kaibrooks/synthy/README.md

# synthy
PROJECT THEREMIZER

This file describes the THEREMIZER built by Bader Almatouq, Kai Brooks, Andrew Forsman, and Jeff Roman in Fall 
of 2019 for ECE 411 at Portland State University.
