kaibrooks/synthy/Homework/Functional Decomposition of Theremizer.pdf

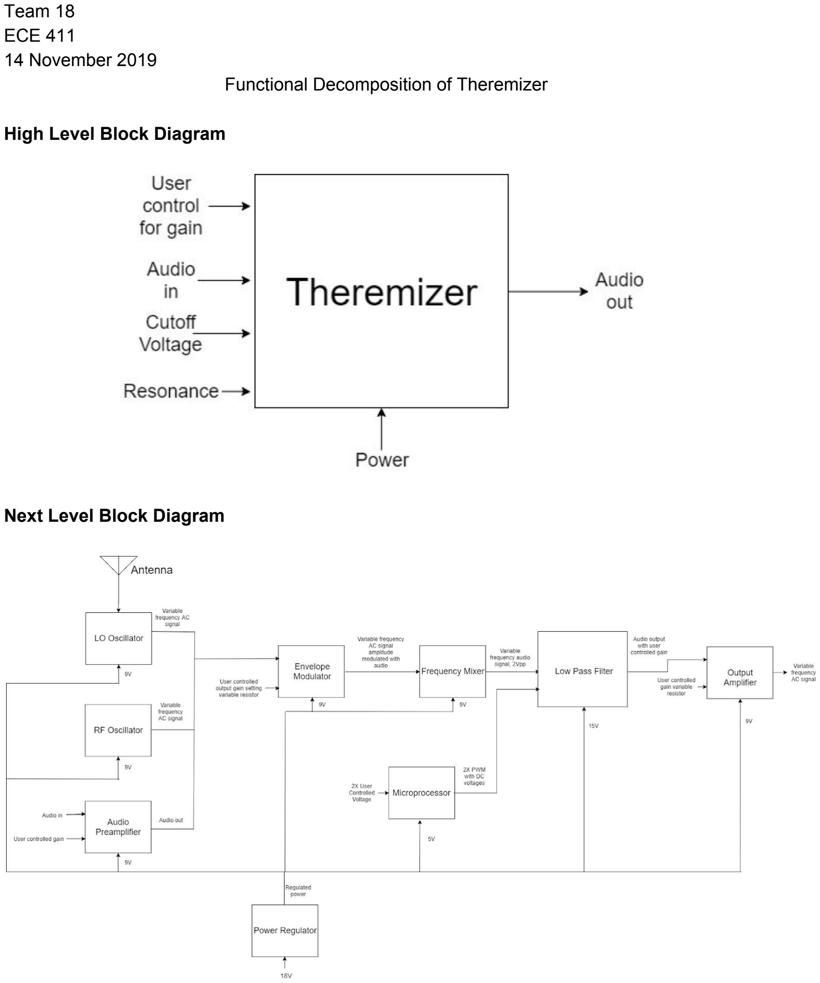
[picture p5: page 1]

Team 18
ECE 411
14 November 2019
Functional Decomposition of Theremizer

High Level Block Diagram

Next Level Block Diagram

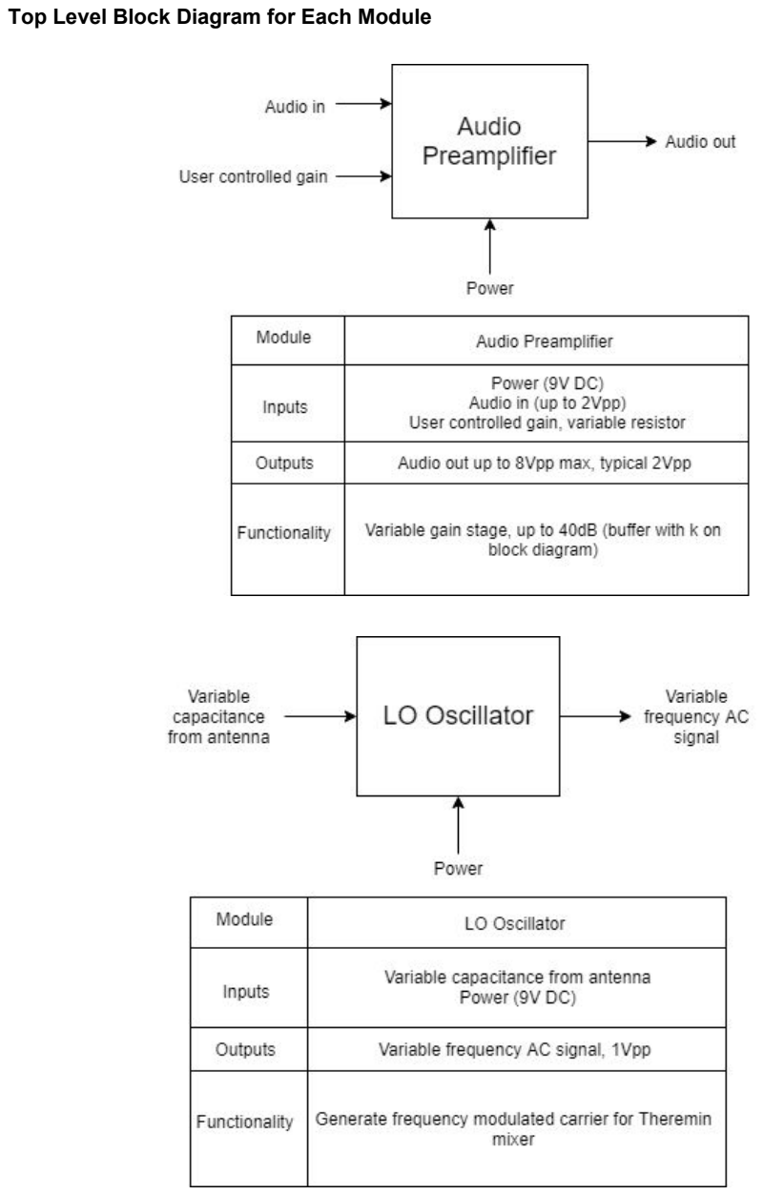
[picture p6: page 2]

Top Level Block Diagram for Each Module

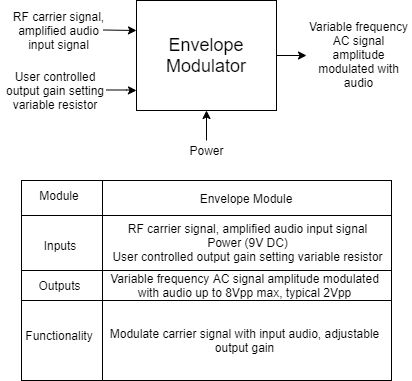
[picture p7: figure]
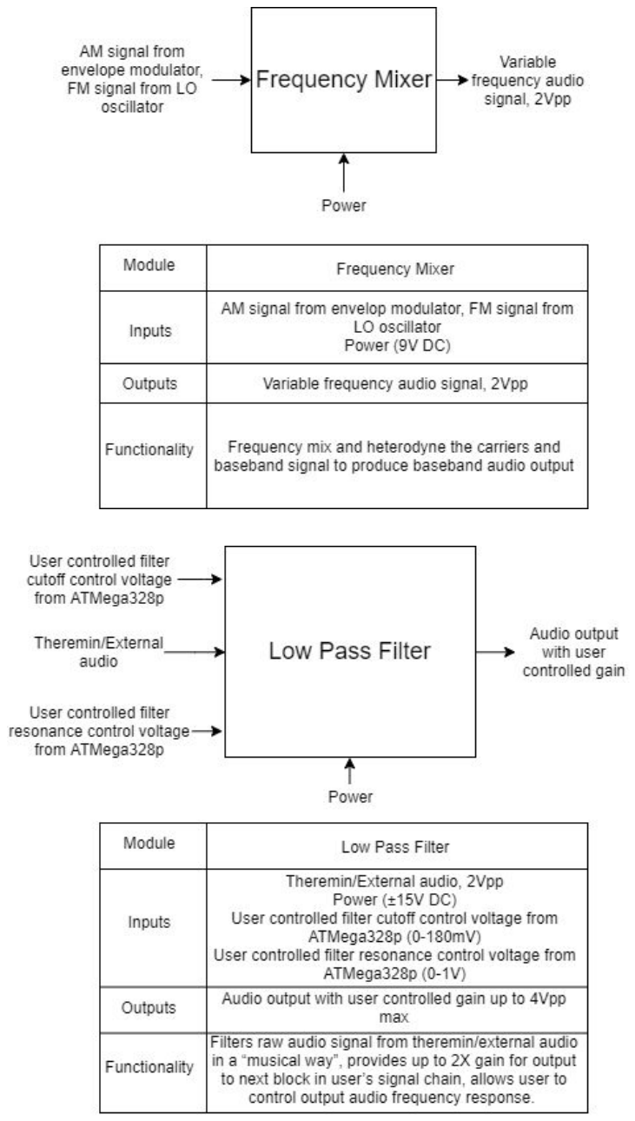
[picture p8: page 4]

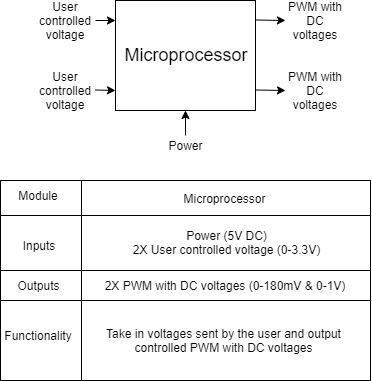
[picture p9: figure]
