kaibrooks/synthy/Breadboard Pics and Vids/Breadboard_Theremin_Powersupply_Filter.jpeg

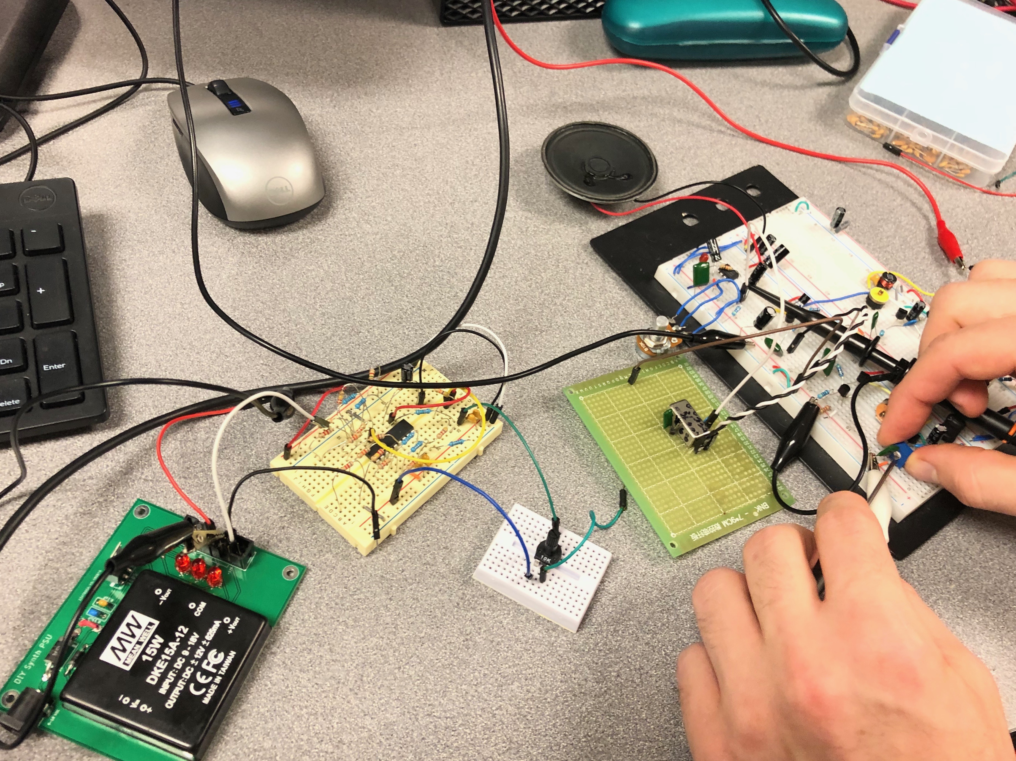
Breadboard Pics and Vids/Breadboard_Theremin_Powersupply_Filter.jpeg
