kaibrooks/synthy/Homework/Theremizer_Level_0_BD.png

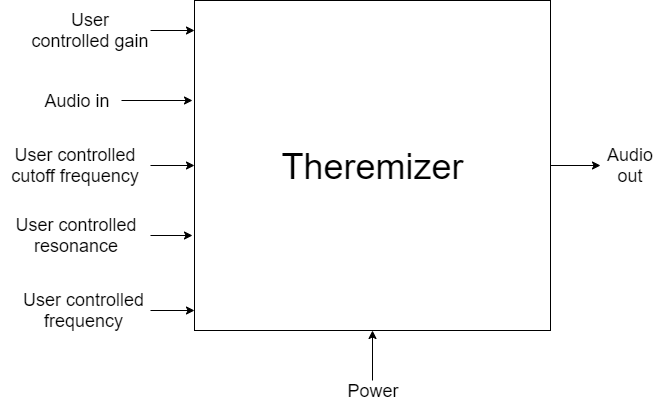
Homework/Theremizer_Level_0_BD.png
