kaibrooks/synthy/Homework/Theremizer_Level_1_BD.png

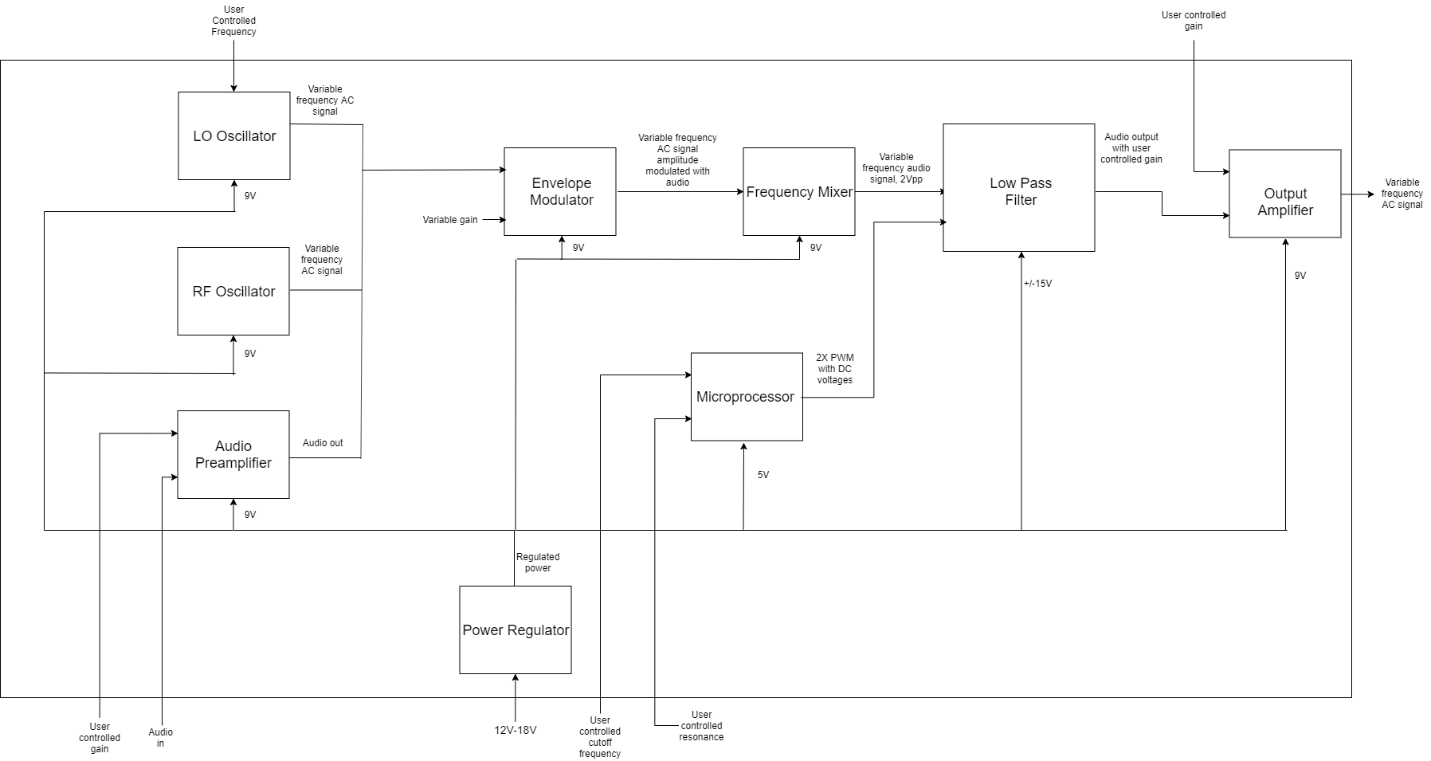
Homework/Theremizer_Level_1_BD.png
