kaibrooks/synthy/images/kitty.jpg

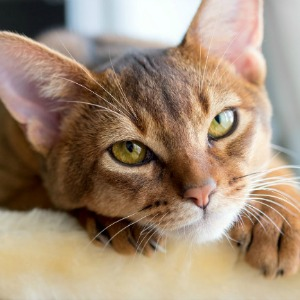
images/kitty.jpg
