kaibrooks/synthy/images/PCB layout.png

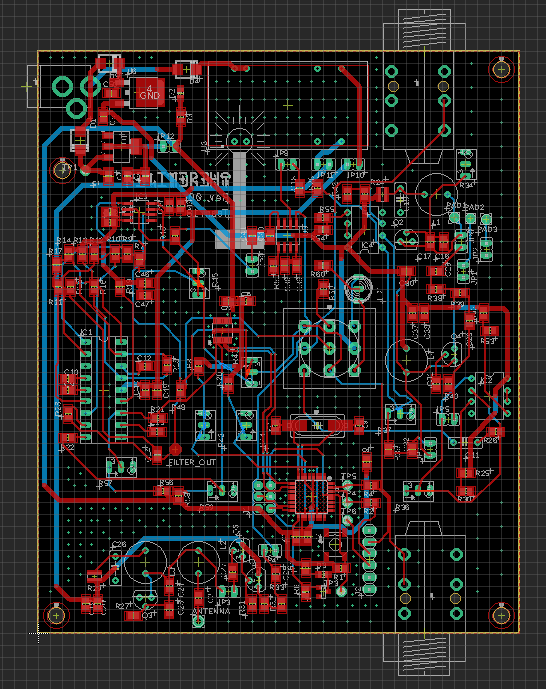
images/PCB layout.png
