kaibrooks/synthy/images/PWM_Code_Capture.PNG

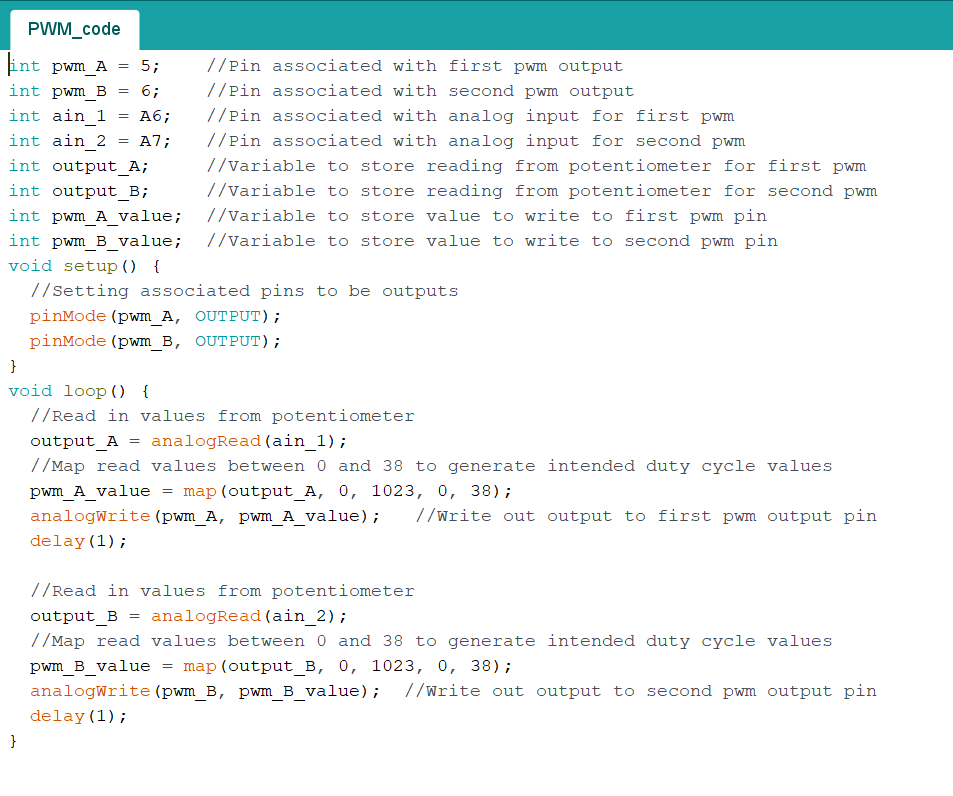
images/PWM_Code_Capture.PNG
