kaibrooks/synthy/EAGLE/Digikey Theremizer BOM.txt

Manufacturer Part Number	Manufacturer	Digi-Key Part Number	Customer Reference	Reference Designator	Packaging	Part Status	Quantity	Unit Price	Extended Price	Quantity Available	Mfg Std Lead Time	Description
PV36W104C01B00	Bourns Inc.	490-2876-ND			Tube	Active	8	1.5	$12.00 	10064	6 Weeks	TRIMMER 100K OHM 0.5W PC PIN TOP
RLB1314-103KL	Bourns Inc.	RLB1314-103KL-ND			Bag	Active	4	0.56	$2.24 	1099	14 Weeks	FIXED IND 10MH 100MA 12 OHM TH
RLB0608-102KL	Bourns Inc.	RLB0608-102KL-ND			Bag	Active	10	0.28	$2.80 	110816	14 Weeks	FIXED IND 1MH 100MA 11.5 OHM TH
RL622-101K-RC	Bourns Inc.	M9993-ND			Bulk	Active	4	0.95	$3.80 	10872	18 Weeks	FIXED IND 100UH 910MA 280 MOHM
PRG3216P-1000-D-T5	Susumu	408-1805-1-ND			Cut Tape (CT)	Active	10	0.491	$4.91 	1400	20 Weeks	RES SMD 100 OHM 1W 1206 WIDE
ERJ-PB6B4700V	Panasonic Electronic Components	P20556CT-ND			Cut Tape (CT)	Active	25	0.2228	$5.57 	9416	13 Weeks	RES SMD 470 OHM 0.1% 1/4W 0805
RK73H2ATTD47R0F	"KOA Speer Electronics, Inc."	2019-RK73H2ATTD47R0FCT-ND			Cut Tape (CT)	Active	10	0.035	$0.35 	21644	Not Available	RESISTOR
C0805C222KAGECAUTO	KEMET	399-17905-1-ND			Cut Tape (CT)	Active	20	0.196	$3.92 	4558	18 Weeks	CAP CER 0805 2.2NF 250V C0G
C0805C471F1GACTU	KEMET	399-8082-6-ND			Digi-Reel	Active	20	0.804	$16.08 	24430	46 Weeks	CAP CER 470PF 100V C0G/NP0 0805
C0805C104K3RACTU	KEMET	399-1168-1-ND			Cut Tape (CT)	Active	100	0.0646	$6.46 	899523	54 Weeks	CAP CER 0.1UF 25V X7R 0805
UKL2A100KPD	Nichicon	493-14498-ND			Bulk	Active	12	0.398	$4.77 	1209	19 Weeks	CAP ALUM 10UF 10% 100V RADIAL
STC02SYAN	Sullins Connector Solutions	S9000-ND			Bulk	Active	50	0.1	$5.00 	105643	5 Weeks	CONN JUMPER SHORTING TIN
ERJ-6GEY0R00V	Panasonic Electronic Components	P0.0ACT-ND			Cut Tape (CT)	Active	25	0.1	$2.50 	2004958	11 Weeks	RES SMD 0 OHM JUMPER 1/8W 0805
ERJ-6ENF1501V	Panasonic Electronic Components	P1.50KCCT-ND			Cut Tape (CT)	Active	10	0.1	$1.00 	201610	11 Weeks	RES SMD 1.5K OHM 1% 1/8W 0805
ERJ-6ENF1801V	Panasonic Electronic Components	P1.80KCCT-ND			Cut Tape (CT)	Active	10	0.11	$1.10 	71065	11 Weeks	RES SMD 1.8K OHM 1% 1/8W 0805
ERJ-6ENF1003V	Panasonic Electronic Components	P100KCCT-ND			Cut Tape (CT)	Active	100	0.1	$10.00 	1954422	11 Weeks	RES SMD 100K OHM 1% 1/8W 0805
PMV45EN2R	Nexperia USA Inc.	1727-2307-1-ND			Cut Tape (CT)	Active	5	0.43	$2.15 	93483	4 Weeks	MOSFET N-CH 30V SOT23
NCP1117ST50T3G	ON Semiconductor	NCP1117ST50T3GOSCT-ND			Cut Tape (CT)	Active	5	0.47	$2.35 	14163	4 Weeks	IC REG LINEAR 5V 1A SOT223
UA78M09CKVURG3	Texas Instruments	296-19533-1-ND			Cut Tape (CT)	Active	5	0.56	$2.80 	5206	6 Weeks	IC REG LINEAR 9V 500MA TO252-3
TL072CDT	STMicroelectronics	497-2200-1-ND			Cut Tape (CT)	Active	10	0.42	$4.20 	2188	10 Weeks	IC OPAMP JFET 2 CIRCUIT 8SO
ATMEGA328P-AU	Microchip Technology	ATMEGA328P-AU-ND			Tray	Active	4	2.01	$8.04 	5775	10 Weeks	IC MCU 8BIT 32KB FLASH 32TQFP
LTC2645CMS-L8#PBF	Linear Technology/Analog Devices	LTC2645CMS-L8#PBF-ND			Tube	Active	4	6.17	$24.68 	270	16 Weeks	IC DAC 8BIT V-OUT 16MSOP
MBRA130LT3G	ON Semiconductor	MBRA130LT3GOSCT-ND			Cut Tape (CT)	Active	20	0.37	$7.40 	44606	6 Weeks	DIODE SCHOTTKY 30V 1A SMA
LTST-C171GKT	Lite-On Inc.	160-1423-1-ND			Cut Tape (CT)	Active	10	0.28	$2.80 	284148	8 Weeks	LED GREEN CLEAR CHIP SMD
ECS-160-18-5PX-JES-TR	ECS Inc.	XC3075CT-ND			Cut Tape (CT)	Active	5	0.63	$3.15 	1972	9 Weeks	CRYSTAL 16.0000MHZ 18PF SMD
C0805C300K5GAC7800	KEMET	399-17443-1-ND			Cut Tape (CT)	Active	10	0.32	$3.20 	3822	47 Weeks	CAP CER 30PF 50V NP0 0805
C0805C221K5GACTU	KEMET	399-8038-1-ND			Cut Tape (CT)	Active	10	0.14	$1.40 	54135	46 Weeks	CAP CER 220PF 50V C0G/NP0 0805
CC0805KRX7R9BB301	Yageo	311-4329-1-ND			Cut Tape (CT)	Active	20	0.16	$3.20 	1232	17 Weeks	CAP CER 300PF 50V X7R 0805
C0805C102K5GACTU	KEMET	399-7988-1-ND			Cut Tape (CT)	Active	10	0.16	$1.60 	66815	52 Weeks	CAP CER 1000PF 50V C0G/NP0 0805
C0805C473K5RACTU	KEMET	399-1166-1-ND			Cut Tape (CT)	Active	5	0.18	$0.90 	1272598	29 Weeks	CAP CER 0.047UF 50V X7R 0805
C0805C334K5RACAUTO	KEMET	399-6959-1-ND			Cut Tape (CT)	Active	5	0.23	$1.15 	16103	27 Weeks	CAP CER 0.33UF 50V X7R 0805
C0805C105K5PAC7800	KEMET	399-15436-1-ND			Cut Tape (CT)	Active	5	0.33	$1.65 	11400	Not Available	CAP CER 1UF 50V X5R 0805
C0805C106K4PACTU	KEMET	399-8012-1-ND			Cut Tape (CT)	Active	100	0.19	$19.00 	84000	54 Weeks	CAP CER 10UF 16V X5R 0805
C0805C474J5RACTU	KEMET	399-11174-1-ND			Cut Tape (CT)	Active	5	0.98	$4.90 	9232	28 Weeks	CAP CER 0.47UF 50V X7R 0805
ERJ-6ENF9102V	Panasonic Electronic Components	P91.0KCCT-ND			Cut Tape (CT)	Active	20	0.1	$2.00 	50656	11 Weeks	RES SMD 91K OHM 1% 1/8W 0805
ERJ-6ENF2203V	Panasonic Electronic Components	P220KCCT-ND			Cut Tape (CT)	Active	20	0.1	$2.00 	312371	11 Weeks	RES SMD 220K OHM 1% 1/8W 0805
ERJ-6ENF2743V	Panasonic Electronic Components	P274KCCT-ND			Cut Tape (CT)	Active	10	0.11	$1.10 	73439	11 Weeks	RES SMD 274K OHM 1% 1/8W 0805
ERJ-6ENF1004V	Panasonic Electronic Components	P1.00MCCT-ND			Cut Tape (CT)	Active	5	0.1	$0.50 	280128	11 Weeks	RES SMD 1M OHM 1% 1/8W 0805
ERJ-6ENF4992V	Panasonic Electronic Components	P49.9KCCT-ND			Cut Tape (CT)	Active	20	0.1	$2.00 	346807	11 Weeks	RES SMD 49.9K OHM 1% 1/8W 0805
P160KNP-0EC15A100K	TT Electronics/BI	987-1717-ND			Tray	Active	8	0.79	$6.32 	1273	9 Weeks	POT 100K OHM 1/10W PLASTIC LOG
P160KNP-0QD20B10K	TT Electronics/BI	987-1662-ND			Tray	Active	8	0.79	$6.32 	1277	9 Weeks	POT 10K OHM 1/5W PLASTIC LINEAR
P160KNP-0EC15A25K	TT Electronics/BI	987-1721-ND			Tray	Active	4	0.79	$3.16 	425	9 Weeks	POT 25K OHM 1/10W PLASTIC LOG
ERJ-6ENF2201V	Panasonic Electronic Components	P2.20KCCT-ND			Cut Tape (CT)	Active	10	0.1	$1.00 	238068	11 Weeks	RES SMD 2.2K OHM 1% 1/8W 0805
ERJ-6ENF1001V	Panasonic Electronic Components	P1.00KCCT-ND			Cut Tape (CT)	Active	30	0.1	$3.00 	1311959	11 Weeks	RES SMD 1K OHM 1% 1/8W 0805
ERJ-6ENF1002V	Panasonic Electronic Components	P10.0KCCT-ND			Cut Tape (CT)	Active	25	0.1	$2.50 	2268302	11 Weeks	RES SMD 10K OHM 1% 1/8W 0805
ERJ-6ENF4703V	Panasonic Electronic Components	P470KCCT-ND			Cut Tape (CT)	Active	10	0.1	$1.00 	128684	11 Weeks	RES SMD 470K OHM 1% 1/8W 0805
P160KNP-0EC15A500K	TT Electronics/BI	987-1722-ND			Tray	Active	4	0.79	$3.16 	1139	9 Weeks	POT 500K OHM 1/10W PLASTIC LOG
3002	Adafruit Industries LLC	1528-2039-ND			Bulk	Active	4	0.63	$2.52 	394	12 Weeks	SHORT FEATHER MALE HEADERS - 12-
ERJ-6ENF1502V	Panasonic Electronic Components	P15.0KCCT-ND			Cut Tape (CT)	Active	10	0.1	$1.00 	293541	11 Weeks	RES SMD 15K OHM 1% 1/8W 0805
DCWN03A-15	MEAN WELL USA Inc.	1866-1277-ND			Tube	Active	4	8.83	$35.32 	55	14 Weeks	DC DC CONVERTER +/-15V 3W
PJ-202A	CUI Devices	CP-202A-ND			Bag	Active	4	0.6	$2.40 	13054	11 Weeks	CONN PWR JACK 2X5.5MM KINKED PIN
RS-187R05A2-DS MT RT	C&K	CKN10361CT-ND			Cut Tape (CT)	Active	4	0.53	$2.12 	6547	7 Weeks	SWITCH TACTILE SPST-NO 0.05A 12V
1003P1T1B1M2QEH	E-Switch	EG2425-ND			Bulk	Active	4	5.72	$22.88 	121	10 Weeks	SWITCH TOGGLE 3PDT 5A 120V
DILB8P-223TLF	Amphenol ICC (FCI)	609-4717-ND			Tube	Active	8	0.16	$1.28 	127	11 Weeks	CONN IC DIP SOCKET 8POS TIN
DILB16P-223TLF	Amphenol ICC (FCI)	609-4713-ND			Tube	Active	4	0.3	$1.20 	2718	11 Weeks	CONN IC DIP SOCKET 16POS TIN
