kaibrooks/synthy/Final_bom.xlsx

SOURCE | Item #, Name, or Link |  | Item | Cost | Quantity Priced | Used per Build | Quantity to Order | Already Ordered? | Package Details
Amazon | https://www.amazon.com/TOTOT-5-5mm-Female-Socket-Electrical/dp/B077YB75N3 |  | DC Barrel Jacks | 5.99 | 10 | 1 | 1 | Yes
 | https://www.amazon.com/gp/product/B077X95CWF/ref=ox_sc_act_title_5?smid=A3S1JN3RP90N86&psc=1 |  | Red/Blue LEDs | 6.79 | 100 | 1 | 1 | Yes
 | https://www.amazon.com/ZXHAO-6-35mm-Socket-Electric-Guitar/dp/B07FB944VD |  | Mono Instrument Jacks | 7.19 | 20 | 2 | 1 | Yes
 | https://www.amazon.com/gp/product/B07233GJ6M/ref=ox_sc_act_title_2?smid=A1TBO7AH1TIA3O&psc=1 |  | PG7 Cable Glands for Antenna Mount | 5.99 | 6 | 1 | 1 | Yes
 | https://www.amazon.com/dp/B071483R3F |  | M2.5 Nylon Standoffs | 12.99 | 270 | 2 | 1 | Yes
 | https://www.amazon.com/gp/product/B00K85965W/ref=ox_sc_act_title_1?smid=ATVPDKIKX0DER&psc=1 |  | LED Mounts | 4.92 | 50 | 1 | 1 | Yes
 | https://www.amazon.com/gp/product/B07M81Y8CS/ref=ox_sc_act_title_3?smid=A26VZBPE6PT1GF&psc=1 |  | Potentiometer Knobs | 12.99 | 20 | 2 | 1 | Yes
 | https://www.amazon.com/gp/product/B07W1JLTGC/ref=ppx_yo_dt_b_asin_title_o00_s00?ie=UTF8&psc=1 |  | 7-section Telescoping Antennas | 7.99 | 2 | 1 | 1 | Yes
 | https://www.amazon.com/gp/product/B07V5GGJXC/ref=ppx_yo_dt_b_asin_title_o03_s00?ie=UTF8&psc=1 |  | J310 FETs | 5.99 | 10 | 3 | 2 | Yes | TO-92
 | https://www.amazon.com/gp/product/B00B88F94A/ref=ppx_yo_dt_b_asin_title_o07_s01?ie=UTF8&psc=1 |  | NE5532 Op-Amps | 7.38 | 10 | 1 | 1 | Yes | DIP-8
 | https://www.amazon.com/Ximimark-MTS-302-Toggle-Switch-Latching/dp/B07GWGN6D4 |  | 3PDT Toggle Switches | 6.59 | 4 | 1 | 1 | Yes
 |  |  | Header Pins, a whole lot of them. | 6.99 | 1 | 1 | 1 | Yes
 |  |  | TL072 Op-Amps | 4.99 |  |  |  |  | DIP-8
EBAY | 223p Trimmer Capacitors, Dual 1-60/1-140 |  | Duplex 60/140pF Trimmer Capacitors | 5.7 | 5 | 1 | 1 | Yes
 |  |  | NE602 Mixers | 8.95 | 10 | 1 | 1 | Yes | SO-8
 |  |  | 2N5088 BJTs | 4.99 | 100 | 2 | 1 | Yes | TO-92
Digi-Key
Description | Manufacturer Part Number | Manufacturer | Digi-Key Part Number | Part Status | Quantity | Unit Price | Extended Price
TRIMMER 100K OHM 0.5W PC PIN TOP | PV36W104C01B00 | Bourns Inc. | 490-2876-ND | Active | 8 | 1.5 | $12.00
FIXED IND 10MH 100MA 12 OHM TH | RLB1314-103KL | Bourns Inc. | RLB1314-103KL-ND | Active | 4 | 0.56 | $2.24
FIXED IND 1MH 100MA 11.5 OHM TH | RLB0608-102KL | Bourns Inc. | RLB0608-102KL-ND | Active | 10 | 0.28 | $2.80
FIXED IND 100UH 910MA 280 MOHM | RL622-101K-RC | Bourns Inc. | M9993-ND | Active | 4 | 0.95 | $3.80
RES SMD 100 OHM 1W 1206 WIDE | PRG3216P-1000-D-T5 | Susumu | 408-1805-1-ND | Active | 10 | 0.491 | $4.91
RES SMD 470 OHM 0.1% 1/4W 0805 | ERJ-PB6B4700V | Panasonic Electronic Components | P20556CT-ND | Active | 25 | 0.2228 | $5.57
RESISTOR | RK73H2ATTD47R0F | KOA Speer Electronics, Inc. | 2019-RK73H2ATTD47R0FCT-ND | Active | 10 | 0.033 | $0.33
CAP CER 0805 2.2NF 250V C0G | C0805C222KAGECAUTO | KEMET | 399-17905-1-ND | Active | 20 | 0.196 | $3.92
CAP CER 470PF 100V C0G/NP0 0805 | C0805C471F1GACTU | KEMET | 399-8082-6-ND | Active | 20 | 0.804 | $16.08
CAP CER 0.1UF 25V X7R 0805 | C0805C104K3RACTU | KEMET | 399-1168-1-ND | Active | 100 | 0.0646 | $6.46
CAP ALUM 10UF 10% 100V RADIAL | UKL2A100KPD | Nichicon | 493-14498-ND | Active | 12 | 0.398 | $4.77
CONN JUMPER SHORTING TIN | STC02SYAN | Sullins Connector Solutions | S9000-ND | Active | 50 | 0.0378 | $1.89
RES SMD 0 OHM JUMPER 1/8W 0805 | ERJ-6GEY0R00V | Panasonic Electronic Components | P0.0ACT-ND | Active | 25 | 0.0432 | $1.08
RES SMD 1.5K OHM 1% 1/8W 0805 | ERJ-6ENF1501V | Panasonic Electronic Components | P1.50KCCT-ND | Active | 10 | 0.075 | $0.75
RES SMD 1.8K OHM 1% 1/8W 0805 | ERJ-6ENF1801V | Panasonic Electronic Components | P1.80KCCT-ND | Active | 10 | 0.089 | $0.89
RES SMD 100K OHM 1% 1/8W 0805 | ERJ-6ENF1003V | Panasonic Electronic Components | P100KCCT-ND | Active | 100 | 0.0275 | $2.75
MOSFET N-CH 30V SOT23 | PMV45EN2R | Nexperia USA Inc. | 1727-2307-1-ND | Active | 5 | 0.43 | $2.15
IC REG LINEAR 5V 1A SOT223 | NCP1117ST50T3G | ON Semiconductor | NCP1117ST50T3GOSCT-ND | Active | 5 | 0.47 | $2.35
IC REG LINEAR 9V 500MA TO252-3 | UA78M09CKVURG3 | Texas Instruments | 296-19533-1-ND | Active | 5 | 0.56 | $2.80
IC OPAMP JFET 2 CIRCUIT 8SO | TL072CDT | STMicroelectronics | 497-2200-1-ND | Active | 10 | 0.363 | $3.63
IC MCU 8BIT 32KB FLASH 32TQFP | ATMEGA328P-AU | Microchip Technology | ATMEGA328P-AU-ND | Active | 4 | 2.01 | $8.04
IC DAC 8BIT V-OUT 16MSOP | LTC2645CMS-L8#PBF | Linear Technology/Analog Devices | LTC2645CMS-L8#PBF-ND | Active | 4 | 6.17 | $24.68
DIODE SCHOTTKY 30V 1A SMA | MBRA130LT3G | ON Semiconductor | MBRA130LT3GOSCT-ND | Active | 20 | 0.28 | $5.60
LED GREEN CLEAR CHIP SMD | LTST-C171GKT | Lite-On Inc. | 160-1423-1-ND | Active | 10 | 0.201 | $2.01
CRYSTAL 16.0000MHZ 18PF SMD | ECS-160-18-5PX-JES-TR | ECS Inc. | XC3075CT-ND | Active | 5 | 0.63 | $3.15
CAP CER 30PF 50V NP0 0805 | C0805C300K5GAC7800 | KEMET | 399-17443-1-ND | Active | 10 | 0.216 | $2.16
CAP CER 220PF 50V C0G/NP0 0805 | C0805C221K5GACTU | KEMET | 399-8038-1-ND | Active | 10 | 0.101 | $1.01
CAP CER 300PF 50V X7R 0805 | CC0805KRX7R9BB301 | Yageo | 311-4329-1-ND | Active | 20 | 0.111 | $2.22
CAP CER 1000PF 50V C0G/NP0 0805 | C0805C102K5GACTU | KEMET | 399-7988-1-ND | Active | 10 | 0.112 | $1.12
CAP CER 0.047UF 50V X7R 0805 | C0805C473K5RACTU | KEMET | 399-1166-1-ND | Active | 5 | 0.18 | $0.90
CAP CER 0.33UF 50V X7R 0805 | C0805C334K5RACAUTO | KEMET | 399-6959-1-ND | Active | 5 | 0.23 | $1.15
CAP CER 1UF 50V X5R 0805 | C0805C105K5PAC7800 | KEMET | 399-15436-1-ND | Active | 5 | 0.33 | $1.65
CAP CER 10UF 16V X5R 0805 | C0805C106K4PACTU | KEMET | 399-8012-1-ND | Active | 100 | 0.0663 | $6.63
CAP CER 0.47UF 50V X7R 0805 | C0805C474J5RACTU | KEMET | 399-11174-1-ND | Active | 5 | 0.98 | $4.90
RES SMD 91K OHM 1% 1/8W 0805 | ERJ-6ENF9102V | Panasonic Electronic Components | P91.0KCCT-ND | Active | 20 | 0.072 | $1.44
RES SMD 220K OHM 1% 1/8W 0805 | ERJ-6ENF2203V | Panasonic Electronic Components | P220KCCT-ND | Active | 20 | 0.072 | $1.44
RES SMD 274K OHM 1% 1/8W 0805 | ERJ-6ENF2743V | Panasonic Electronic Components | P274KCCT-ND | Active | 10 | 0.087 | $0.87
RES SMD 1M OHM 1% 1/8W 0805 | ERJ-6ENF1004V | Panasonic Electronic Components | P1.00MCCT-ND | Active | 5 | 0.1 | $0.50
RES SMD 49.9K OHM 1% 1/8W 0805 | ERJ-6ENF4992V | Panasonic Electronic Components | P49.9KCCT-ND | Active | 20 | 0.072 | $1.44
POT 100K OHM 1/10W PLASTIC LOG | P160KNP-0EC15A100K | TT Electronics/BI | 987-1717-ND | Active | 8 | 0.79 | $6.32
POT 10K OHM 1/5W PLASTIC LINEAR | P160KNP-0QD20B10K | TT Electronics/BI | 987-1662-ND | Active | 8 | 0.79 | $6.32
POT 25K OHM 1/10W PLASTIC LOG | P160KNP-0EC15A25K | TT Electronics/BI | 987-1721-ND | Active | 4 | 0.79 | $3.16
RES SMD 2.2K OHM 1% 1/8W 0805 | ERJ-6ENF2201V | Panasonic Electronic Components | P2.20KCCT-ND | Active | 10 | 0.074 | $0.74
RES SMD 1K OHM 1% 1/8W 0805 | ERJ-6ENF1001V | Panasonic Electronic Components | P1.00KCCT-ND | Active | 30 | 0.072 | $2.16
RES SMD 10K OHM 1% 1/8W 0805 | ERJ-6ENF1002V | Panasonic Electronic Components | P10.0KCCT-ND | Active | 25 | 0.072 | $1.80
RES SMD 470K OHM 1% 1/8W 0805 | ERJ-6ENF4703V | Panasonic Electronic Components | P470KCCT-ND | Active | 10 | 0.072 | $0.72
POT 500K OHM 1/10W PLASTIC LOG | P160KNP-0EC15A500K | TT Electronics/BI | 987-1722-ND | Active | 4 | 0.79 | $3.16
SHORT FEATHER MALE HEADERS - 12- | 3002 | Adafruit Industries LLC | 1528-2039-ND | Active | 4 | 0.63 | $2.52
RES SMD 15K OHM 1% 1/8W 0805 | ERJ-6ENF1502V | Panasonic Electronic Components | P15.0KCCT-ND | Active | 10 | 0.072 | $0.72
DC DC CONVERTER +/-15V 3W | DCWN03A-15 | MEAN WELL USA Inc. | 1866-1277-ND | Active | 4 | 9.08 | $36.32
CONN PWR JACK 2X5.5MM KINKED PIN | PJ-202A | CUI Devices | CP-202A-ND | Active | 4 | 0.6 | $2.40
SWITCH TACTILE SPST-NO 0.05A 12V | RS-187R05A2-DS MT RT | C&K | CKN10361CT-ND | Active | 4 | 0.53 | $2.12
SWITCH TOGGLE 3PDT 5A 120V | 1003P1T1B1M2QEH | E-Switch | EG2425-ND | Active | 4 | 5.72 | $22.88
CONN IC DIP SOCKET 8POS TIN | DILB8P-223TLF | Amphenol ICC (FCI) | 609-4717-ND | Active | 8 | 0.16 | $1.28
CONN IC DIP SOCKET 16POS TIN | DILB16P-223TLF | Amphenol ICC (FCI) | 609-4713-ND | Active | 4 | 0.3 | $1.20
CONN HEADER VERT 2POS 2.54MM | M20-9990246 | Harwin Inc. | 952-2262-ND | Active | 50 | 0.099 | $4.95
Total Cost | $367.28
Per Unit | $91.82
