kaibrooks/synthy/Homework/Theremizer_gantt.pdf

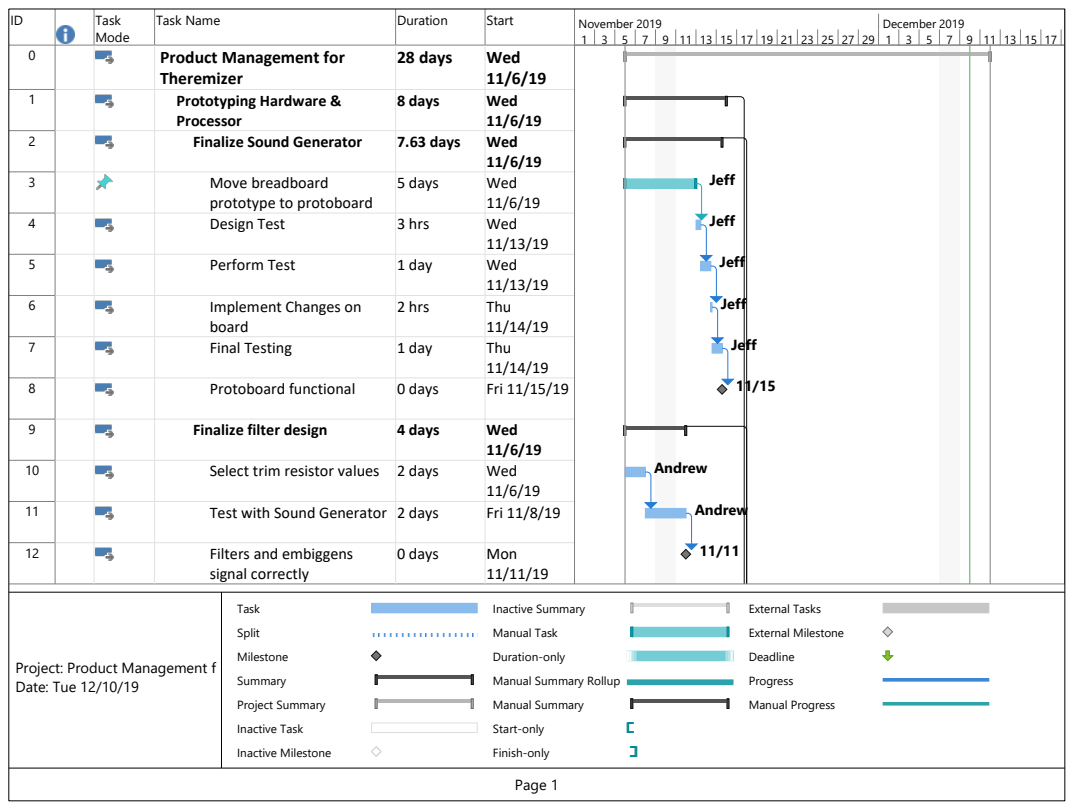
[picture p16: page 1]
Task; Mode; Task Name; Duration; Start; Product Management for; Theremizer; 28 days; Wed; Prototyping Hardware &; Processor; 8 days; Finalize Sound Generator; 7.63 days; Move breadboard; 5 days; Design Test; 3 hrs; Perform Test; 1 day; Implement Changes on; board; 2 hrs; Thu; Final Testing; Protoboard functional; 0 days; Fri 11/15/19; Finalize filter design; 4 days; Select trim resistor values; 2 days; Test with Sound Generator; Fri 11/8/19; Filters and embiggens; signal correctly; Mon; Jeff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

prototype to protoboard

Project: Product Management f
Date: Tue 12/10/19

Manual Summary Rollup

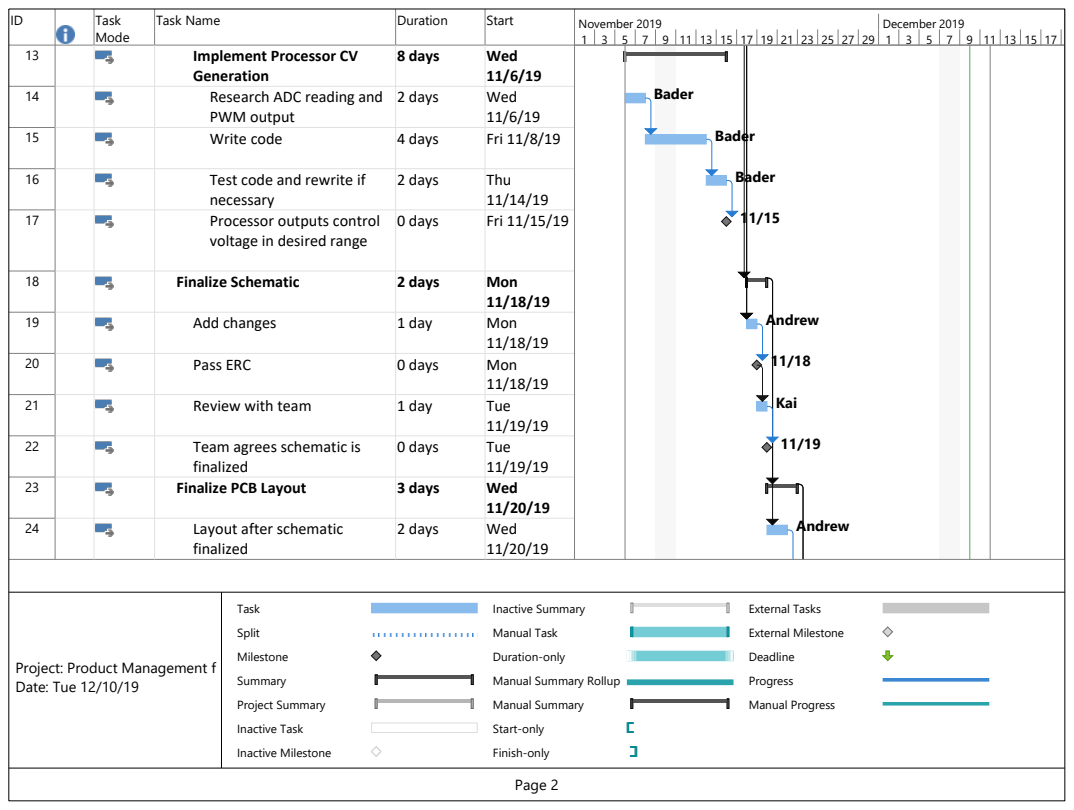
[picture p17: page 2]
Mode; Implement Processor CV; Generation; 8 days; Wed; Research ADC reading and; PWM output; 2 days; Write code; 4 days; Fri 11/8/19; Test code and rewrite if; necessary; Thu; Processor outputs control; 0 days; Fri 11/15/19; Finalize Schematic; Mon; Add changes; 1 day; Pass ERC; Review with team; Tue; Team agrees schematic is; finalized; Finalize PCB Layout; 3 days; Layout after schematic; Bader; Andrew; Kai; Task; Split; Milestone; Summary; Project Summary; Inactive Task; Inactive Milestone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

voltage in desired range

Project: Product Management f
Date: Tue 12/10/19

Manual Summary Rollup

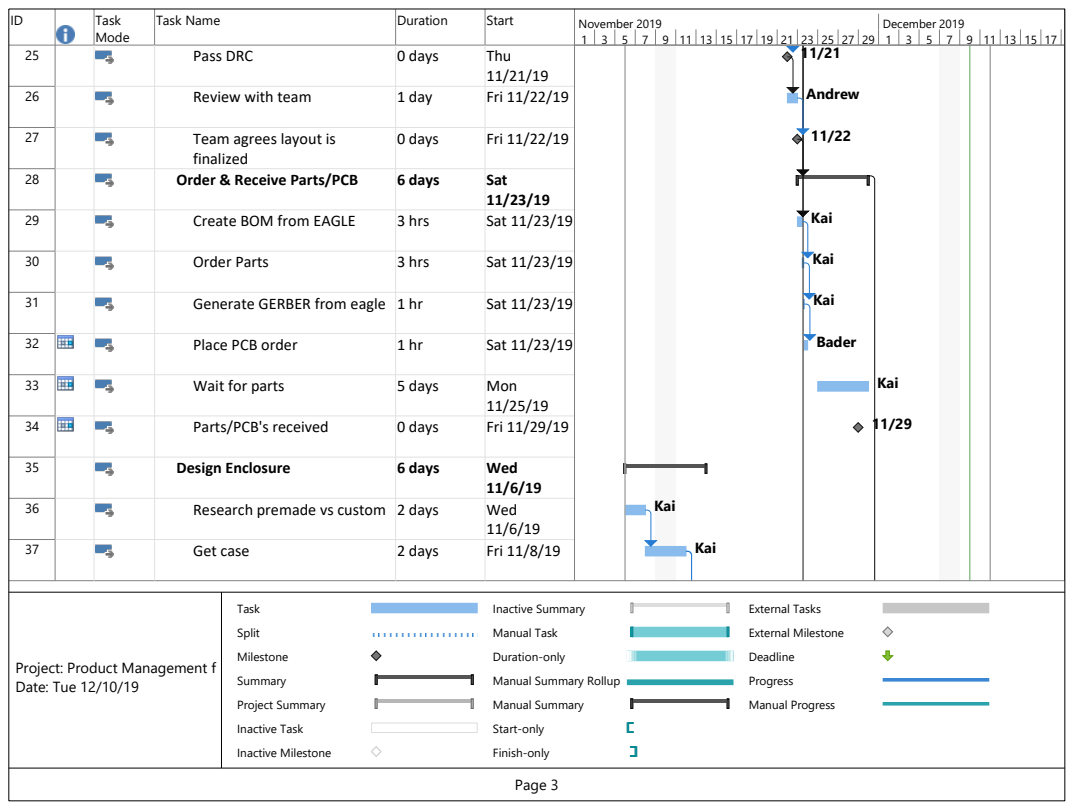
[picture p18: page 3]
Mode; Pass DRC; 0 days; Thu; Review with team; 1 day; Fri 11/22/19; Team agrees layout is; finalized; Order & Receive Parts/PCB; 6 days; Sat; Create BOM from EAGLE; 3 hrs; Sat 11/23/19; Order Parts; Generate GERBER from eagle; Place PCB order; Wait for parts; 5 days; Mon; Parts/PCB's received; Fri 11/29/19; Design Enclosure; Wed; Research premade vs custom; 2 days; Get case; Fri 11/8/19; Andrew; Kai; Bader; Task; Split; Milestone; Summary; Project Summary; Inactive Task; Inactive Milestone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

Project: Product Management f
Date: Tue 12/10/19

Manual Summary Rollup

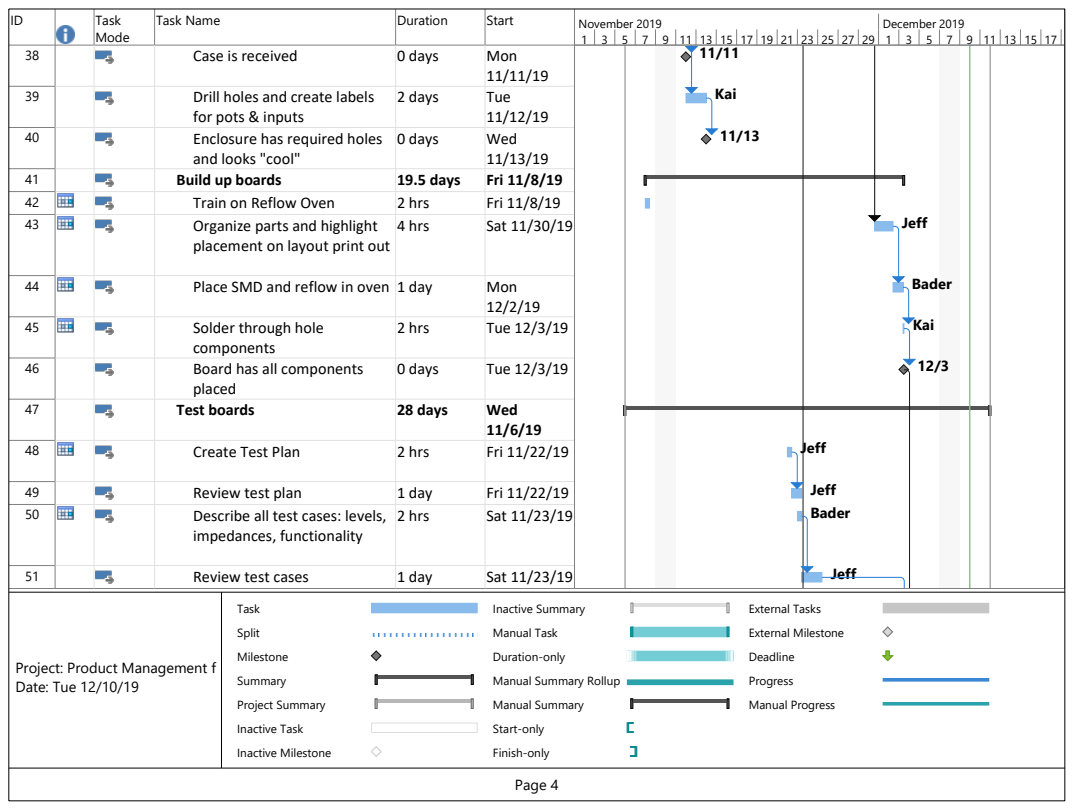
[picture p19: page 4]
Mode; Case is received; 0 days; Mon; Drill holes and create labels; 2 days; Tue; Enclosure has required holes; Wed; Build up boards; 19.5 days; Fri 11/8/19; Train on Reflow Oven; 2 hrs; Organize parts and highlight; 4 hrs; Sat 11/30/19; Place SMD and reflow in oven; 1 day; Solder through hole; components; Tue 12/3/19; Board has all components; placed; Test boards; 28 days; Create Test Plan; Fri 11/22/19; Review test plan; Describe all test cases: levels,; impedances, functionality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

for pots & inputs

and looks "cool"

placement on layout print out

Project: Product Management f
Date: Tue 12/10/19

Manual Summary Rollup

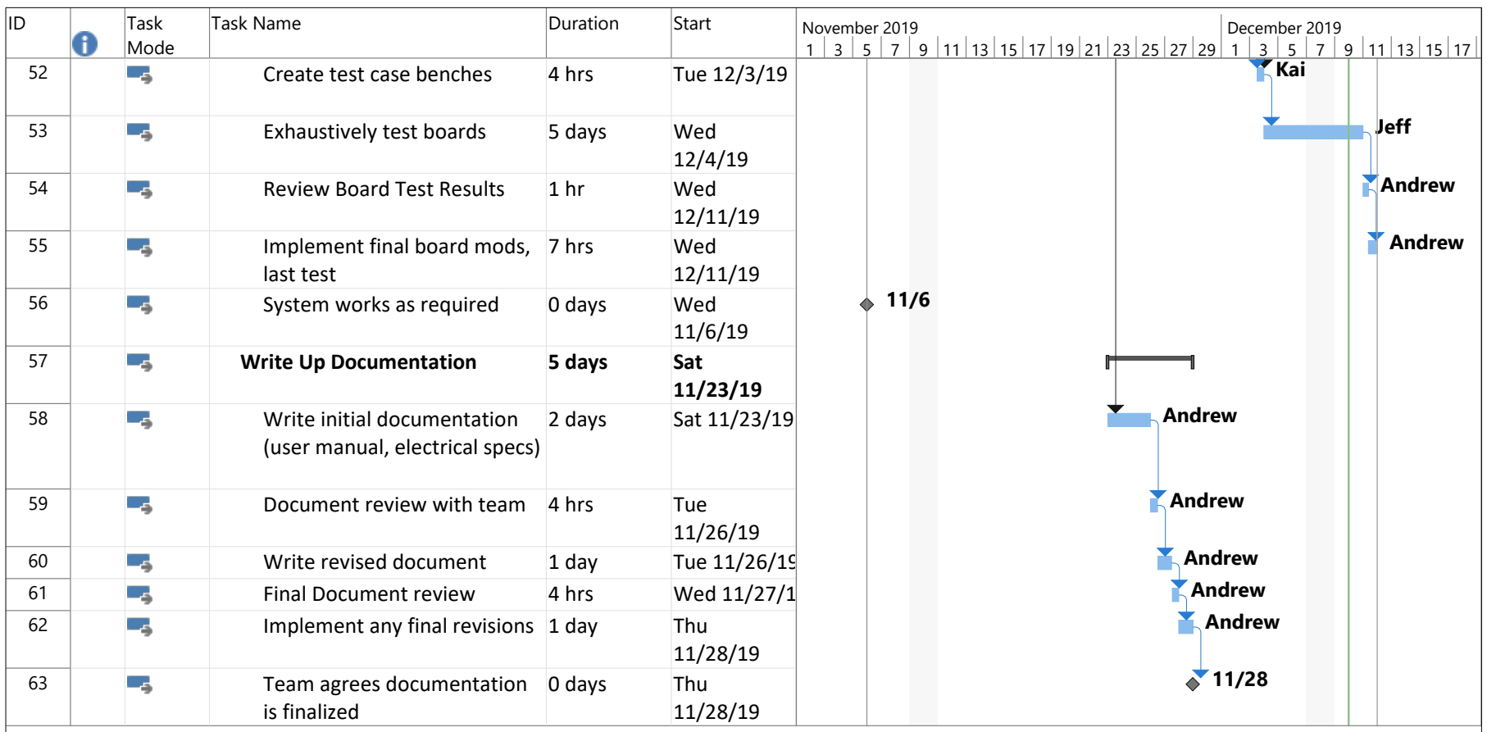
[picture p20: figure]
Mode; Create test case benches; 4 hrs; Tue 12/3/19; Exhaustively test boards; 5 days; Wed; Review Board Test Results; Implement final board mods,; last test; 7 hrs; System works as required; 0 days; Write Up Documentation; Sat; Write initial documentation; (user manual, electrical specs); 2 days; Sat 11/23/19; Document review with team; Tue; Write revised document; 1 day; Tue 11/26/19; Final Document review; Wed 11/27/19; Implement any final revisions; Thu; Team agrees documentation; is finalized; Kai; Jeff; Andrew
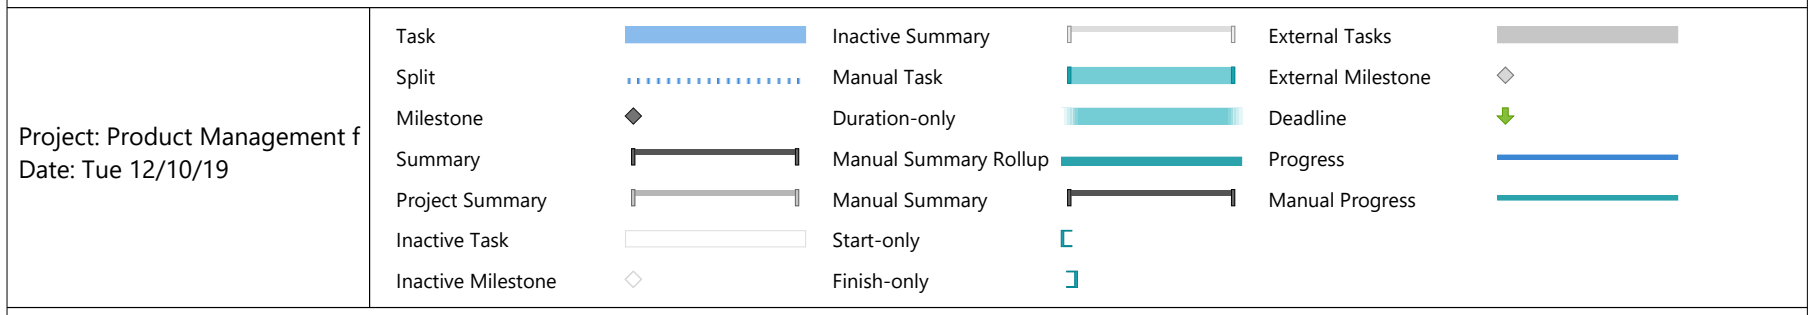
[picture p21: figure]
Task; Split; Milestone; Summary; Project Summary; Inactive Task; Inactive Milestone; Inactive Summary; Manual Task; Duration-only; Manual Summary Rollup; Manual Summary; Start-only; Finish-only; External Tasks; External Milestone; Deadline; Progress; Manual Progress; Project: Product Management f Date: Tue 12/10/19
