kaibrooks/synthy/EAGLE/Theremizer 2.pdf

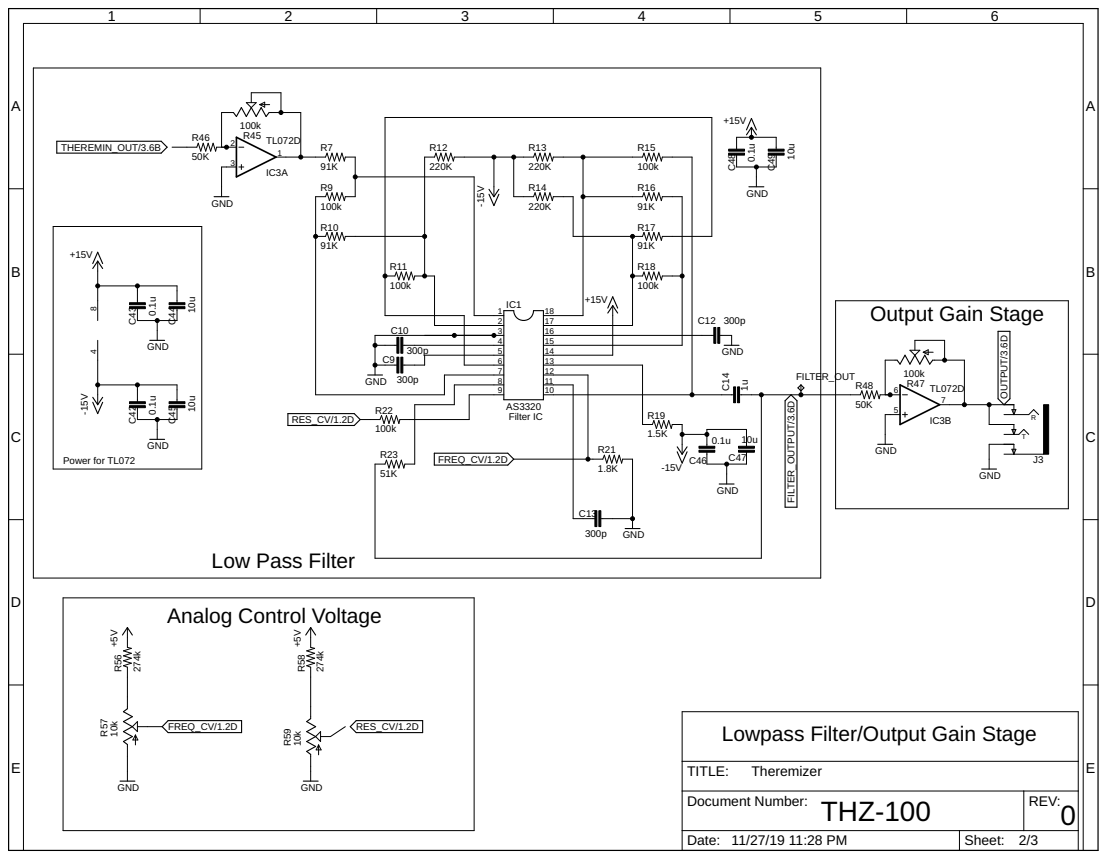
[picture p22: page 1]

Analog Control Voltage

Lowpass Filter/Output Gain Stage

Date: Sheet: 2/3 THZ-100 | REV: TITLE: Document Number: 11/27/19 11:28 PM 0
