kaibrooks/synthy/EAGLE/Theremizer 3.pdf

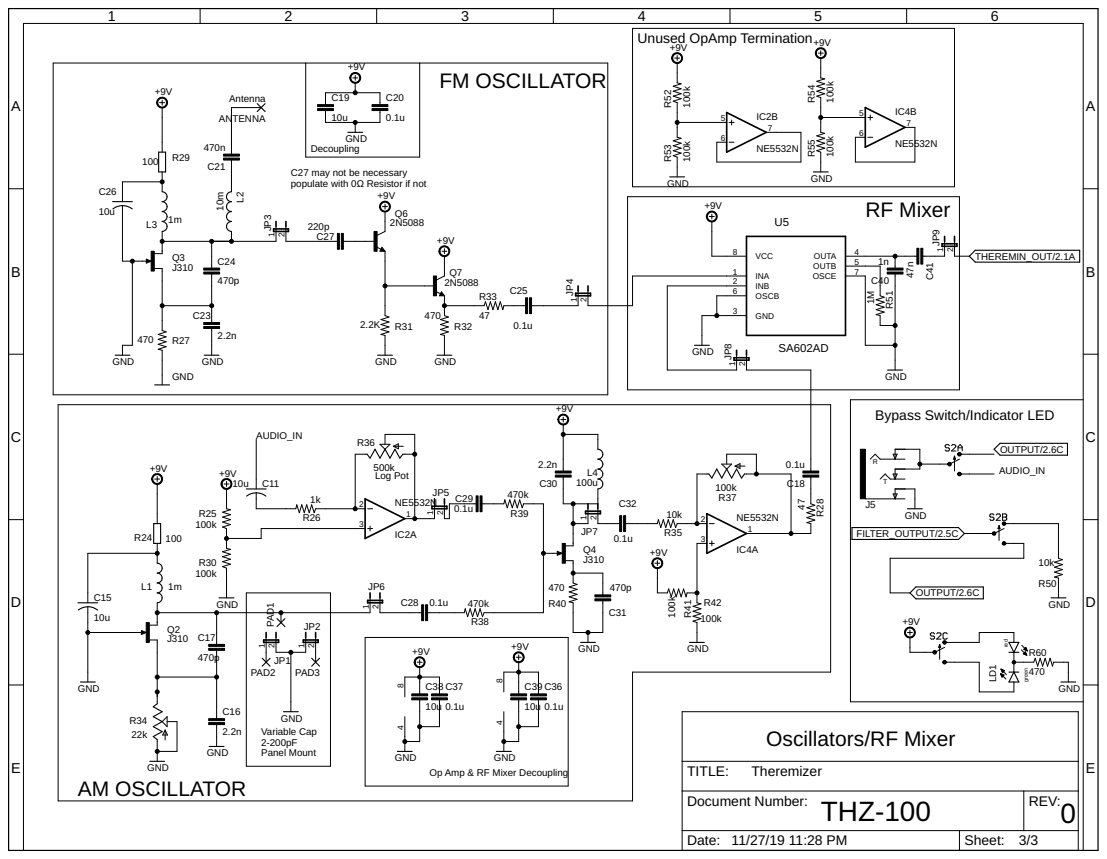
[picture p23: page 1]

Unused OpAmp Termination +9V | +9V

C27 may not be necessary populate with 0Ω Resistor if not Decoupling

Bypass Switch/Indicator LED

Op Amp & RF Mixer Decoupling
