kaibrooks/synthy/EAGLE/Theremizer.pdf

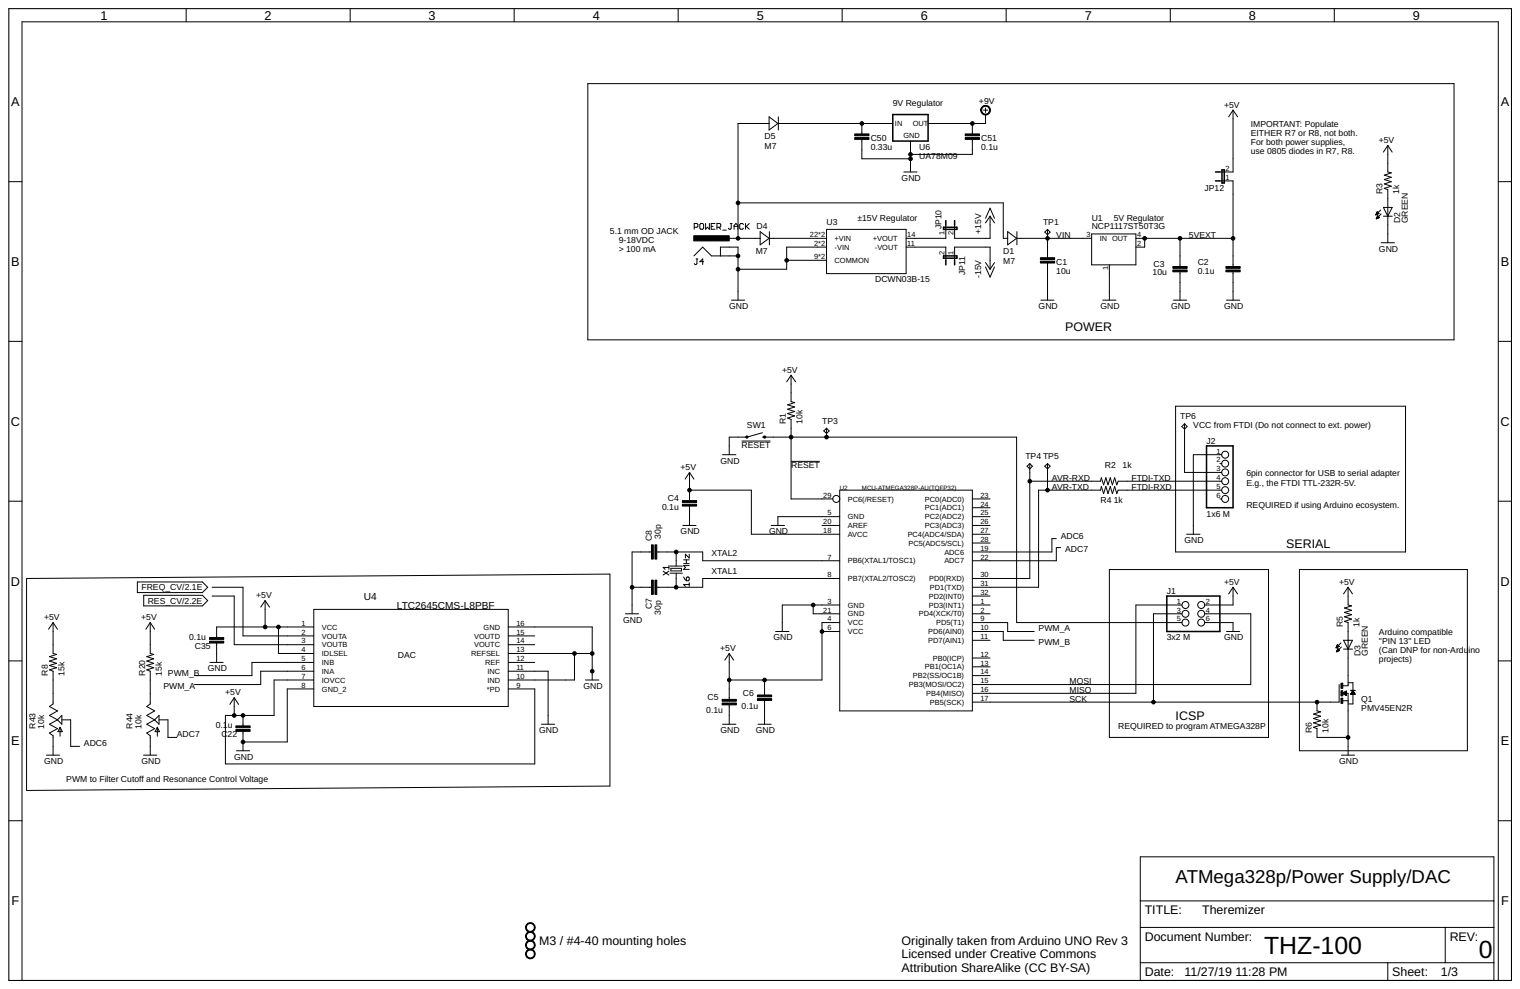
[picture p24: page 1]

IMPORTANT: Populate EITHER R7 or R8, not both. For both power supplies, use 0805 diodes in R7, R8.

VCC from FTDI (Do not connect to ext. power)

6pin connector for USB to serial adapter E.g., the FTDI TTL-232R-5V. REQUIRED if using Arduino ecosystem.

+5V | Arduino compatible "PIN 13" LED (Can DNP for non-Arduino

PWM to Filter Cutoff and Resonance Control Voltage

Originally taken from Arduino UNO Rev 3
Licensed under Creative Commons Attribution ShareAlike (CC BY-SA)


Analog Control Voltage

Lowpass Filter/Output Gain Stage

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


Unused OpAmp Termination +9V | +9V

C27 may not be necessary populate with 0Ω Resistor if not Decoupling

Bypass Switch/Indicator LED

Op Amp & RF Mixer Decoupling
