kaibrooks/synthy/uml assignment/Vaccine_Temperature_Monitoring_UML.pdf

### Vaccine Temperature Monitoring Physical View

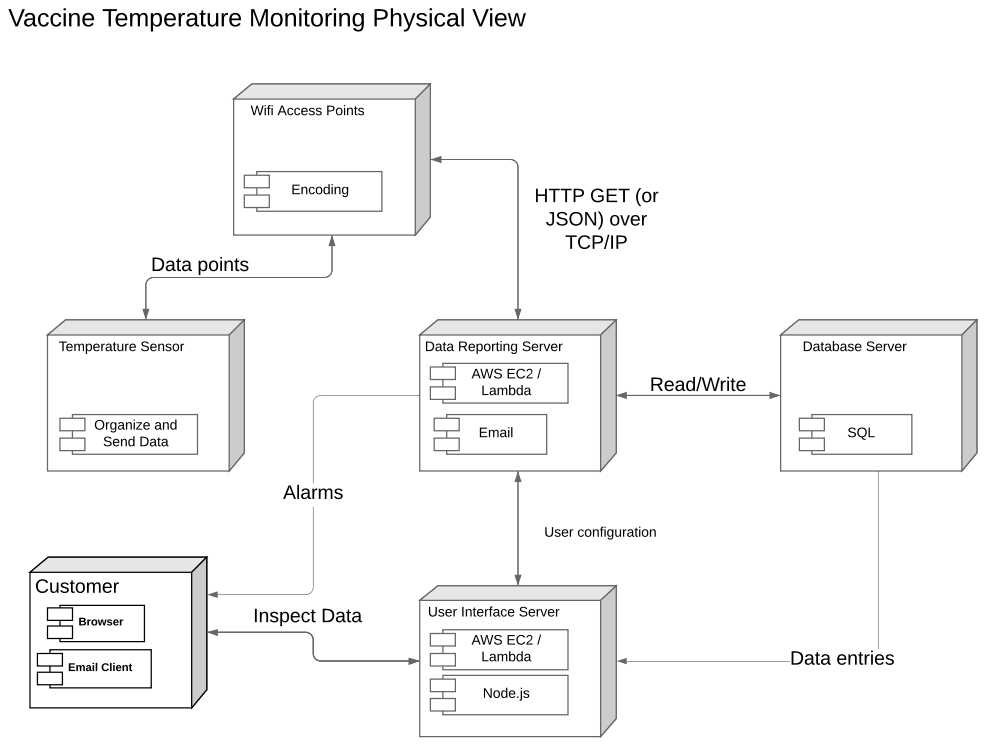
[picture p25: page 1]
Email; Database Server; SQL; Temperature Sensor; Organize and Send Data; User configuration; Encoding; Node.js; Lambda; Read/Write; Data points; Data entries; Customer; Browser; Email Client; Inspect Data; Alarms

Wifi Access Points

HTTP GET (or
JSON) over
TCP/IP

Data Reporting Server
AWS EC2 /

User Interface Server
Lambda

### Vaccine Temperature Monitoring Class Diagram

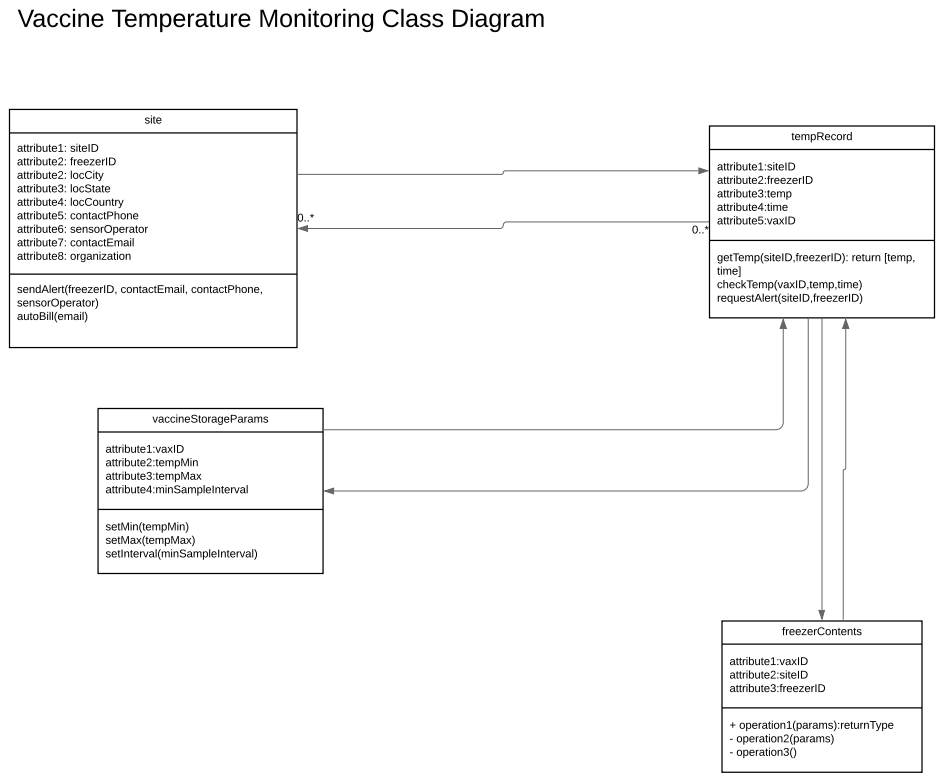
[picture p26: page 2]
site; attribute1: siteID attribute2: freezerID attribute2: locCity attribute3: locState attribute4: locCountry attribute5: contactPhone attribute6: sensorOperator attribute7: contactEmail attribute8: organization; tempRecord; attribute1:siteID attribute2:freezerID attribute3:temp attribute4:time attribute5:vaxID; freezerContents; attribute1:vaxID attribute2:siteID attribute3:freezerID; + operation1(params):returnType - operation2(params) - operation3(); vaccineStorageParams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

getTemp(siteID,freezerID): return [temp,
time]
checkTemp(vaxID,temp,time)
requestAlert(siteID,freezerID)

sendAlert(freezerID, contactEmail, contactPhone,
sensorOperator)
autoBill(email)

### Vaccine Monitoring System Use Case View: Installing a new sensor

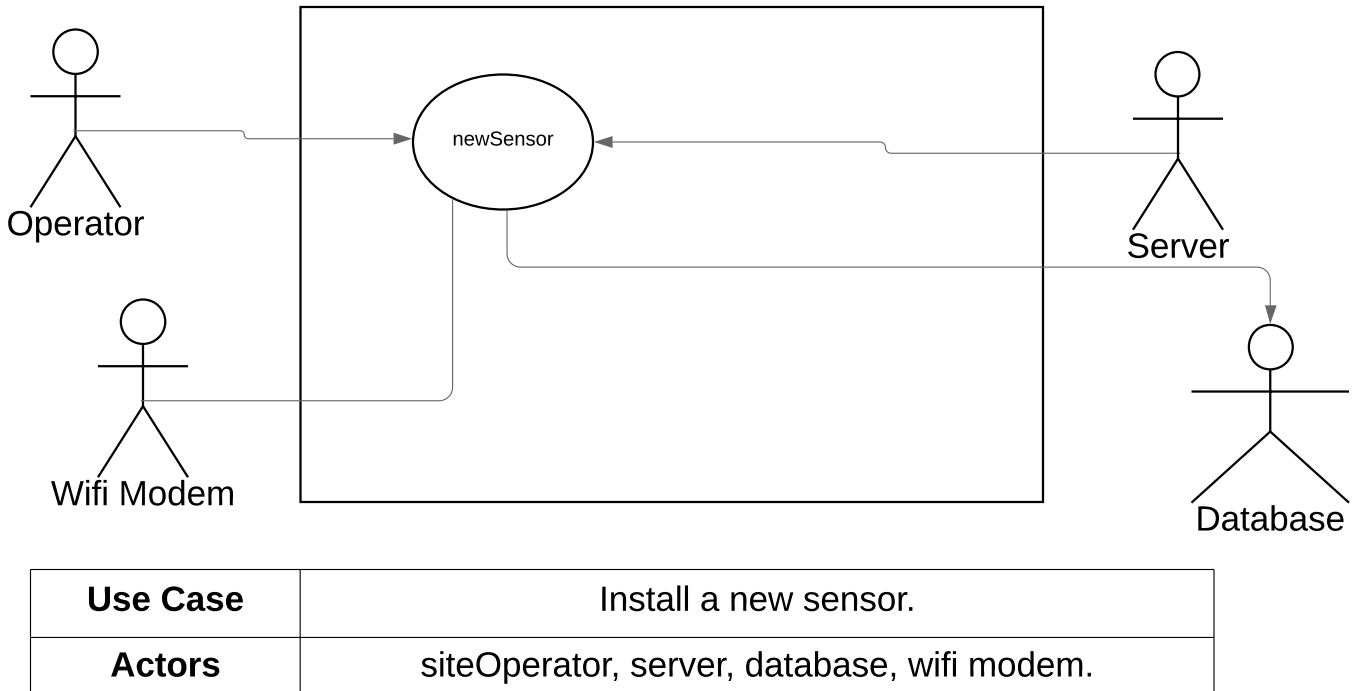
[picture p27: figure]
Operator; newSensor; Database; Server; Wifi Modem; Use Case; Install a new sensor.; Actors; siteOperator, server, database, wifi modem.

Description | siteOperator installs new sensor in a freezer with a vaxID. Sensor establishes connectivity with Wifi modem, then connects to server, which searches for it in the database. Not finding it, server sends back an assignation of xsiteID based on IP address and freezerID based on number of freezers at that site already registered. Server then stores this information in database along with vaxID and adds it to its temp check routines.
Stimulus | | siteOperator plugs sensor in.
Response | | along with metadata into that site's server workflow.

Enable connectivity, register new sensor, incorporate it

### Vaccine Temperature Monitoring Activity View

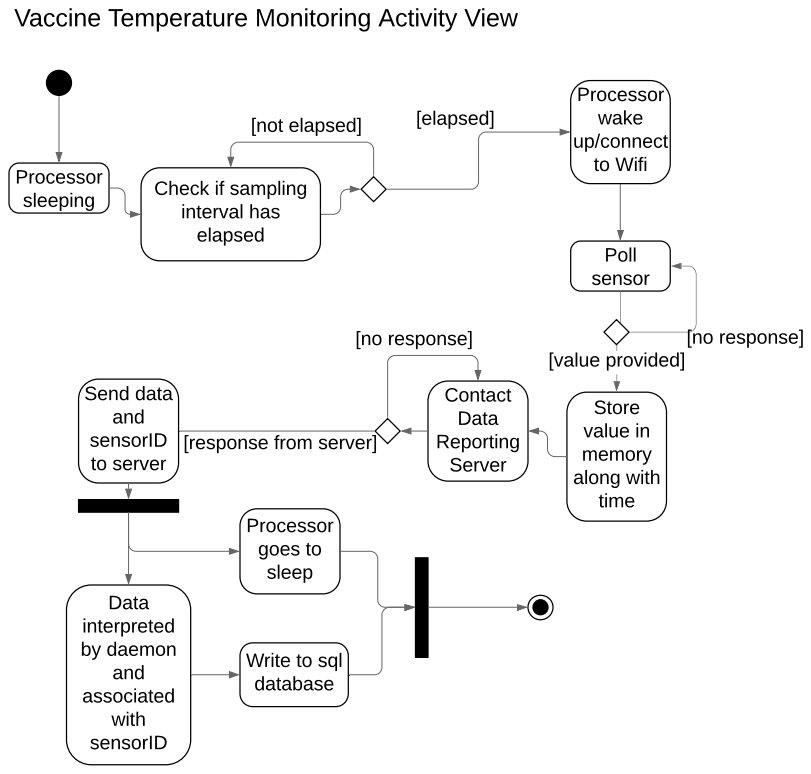
[picture p28: page 4]
[not elapsed]; Processor wake up/connect to Wifi; [elapsed]; Processor sleeping; Poll sensor; Store value in memory along with time; [value provided]; Contact Data Reporting Server; [no response]; Send data and sensorID to server; Data interpreted by daemon and associated with sensorID; Processor goes to sleep

Check if sampling
interval has
elapsed

[response from server]

Write to sql
database
