kaibrooks/synthy/LTSpice/OscillatorToFix.asc

C1: cap; {Cs}
C2: cap; 10µ
C3: cap; 470p
C4: cap; 10µ
C5: cap; 0.1µ
C6: cap; 0.1µ
C7: cap; 470p
C8: cap; 2.2n
C9: cap; 0.1µ
Ctune1: cap; 30p
J1: njf; J310
J3: njf; J310
L1: ind; 1m
L2: ind; 100µ
R1: res; 470
R2: res; 100
R3: res; 470
R5: res; 470k
Vcc1: voltage; 9
Named nets: 0, Vcc
Ctune is 1-60p/1-140p dual variable poly capacitor
.tran 0 .0045 .004
.step param Cs list 2.2n 470p
