kaibrooks/synthy/LTSpice/Theremizer.asc

2N5088-1: npn; 2N5089
2N5088-2: npn; 2N5089
22kpot: res; 470
100kpot: res; 10k
500klogpot: res; 20k
C1: cap; 2.2n
C2: cap; 10µ
C3: cap; 470p
C4: cap; 470n
C5: cap; 10µ
C6: cap; 0.1µ
C7: cap; .1µ
C8: cap; 2.2n
C9: cap; .1µ
C10: cap; 10µ
C11: cap; 10µ
C12: cap; 470p
C13: cap; .1µ
C14: cap; 0.1µ
C15: cap; 470p
C16: cap; 2.2n
C17: cap; 0.1µ
C18: cap; 10µ
C19: cap; 0.1µ
C20: cap; 3pF
Ctune2: cap; 35p
J1: njf; J310
J2: njf; J310
J3: njf; J310
L1: ind; 1m
L2: ind; 10m
L3: ind; 100µ
L4: ind; 1m
NE5532-1: UniversalOpamp2
NE5532-2: UniversalOpamp2
R1: res; 2.2k
R2: res; 100
R3: res; 470
R4: res; 47
R5: res; 100k
R6: res; 100k
R7: res; 470k
R8: res; 100
R9: res; 470k
R10: res; 47
R11: res; 470
R12: res; 10k
R13: res; 100k
R14: res; 100k
R20: res; 1k
R: res; 470
Signal: voltage; AC 1
Vcc: voltage; 9
Named nets: 0, Vcc, Antenna, Input, TestPoint/RF, input, TestPoint/LO
.ac dec 100 10 20k
AM OSCILLATOR
FM OSCILLATOR
Wes Hayward's termination-insensitive output buffer to provide 50 ohms to mixer
BJT's are actually 2n5088, not 2n5089. 2n3904 also work.
Single FET mixer stage makes AM
Amplify the AM
Test Points take form of simple PCB through-hole on the node for external header/jumper wire
Ctune is 1-60p/1-140p dual variable poly capacitor
