kaibrooks/synthy/EAGLE/Theremizer.brd

## EAGLE design EAGLE/Theremizer.brd (2019-12-11)

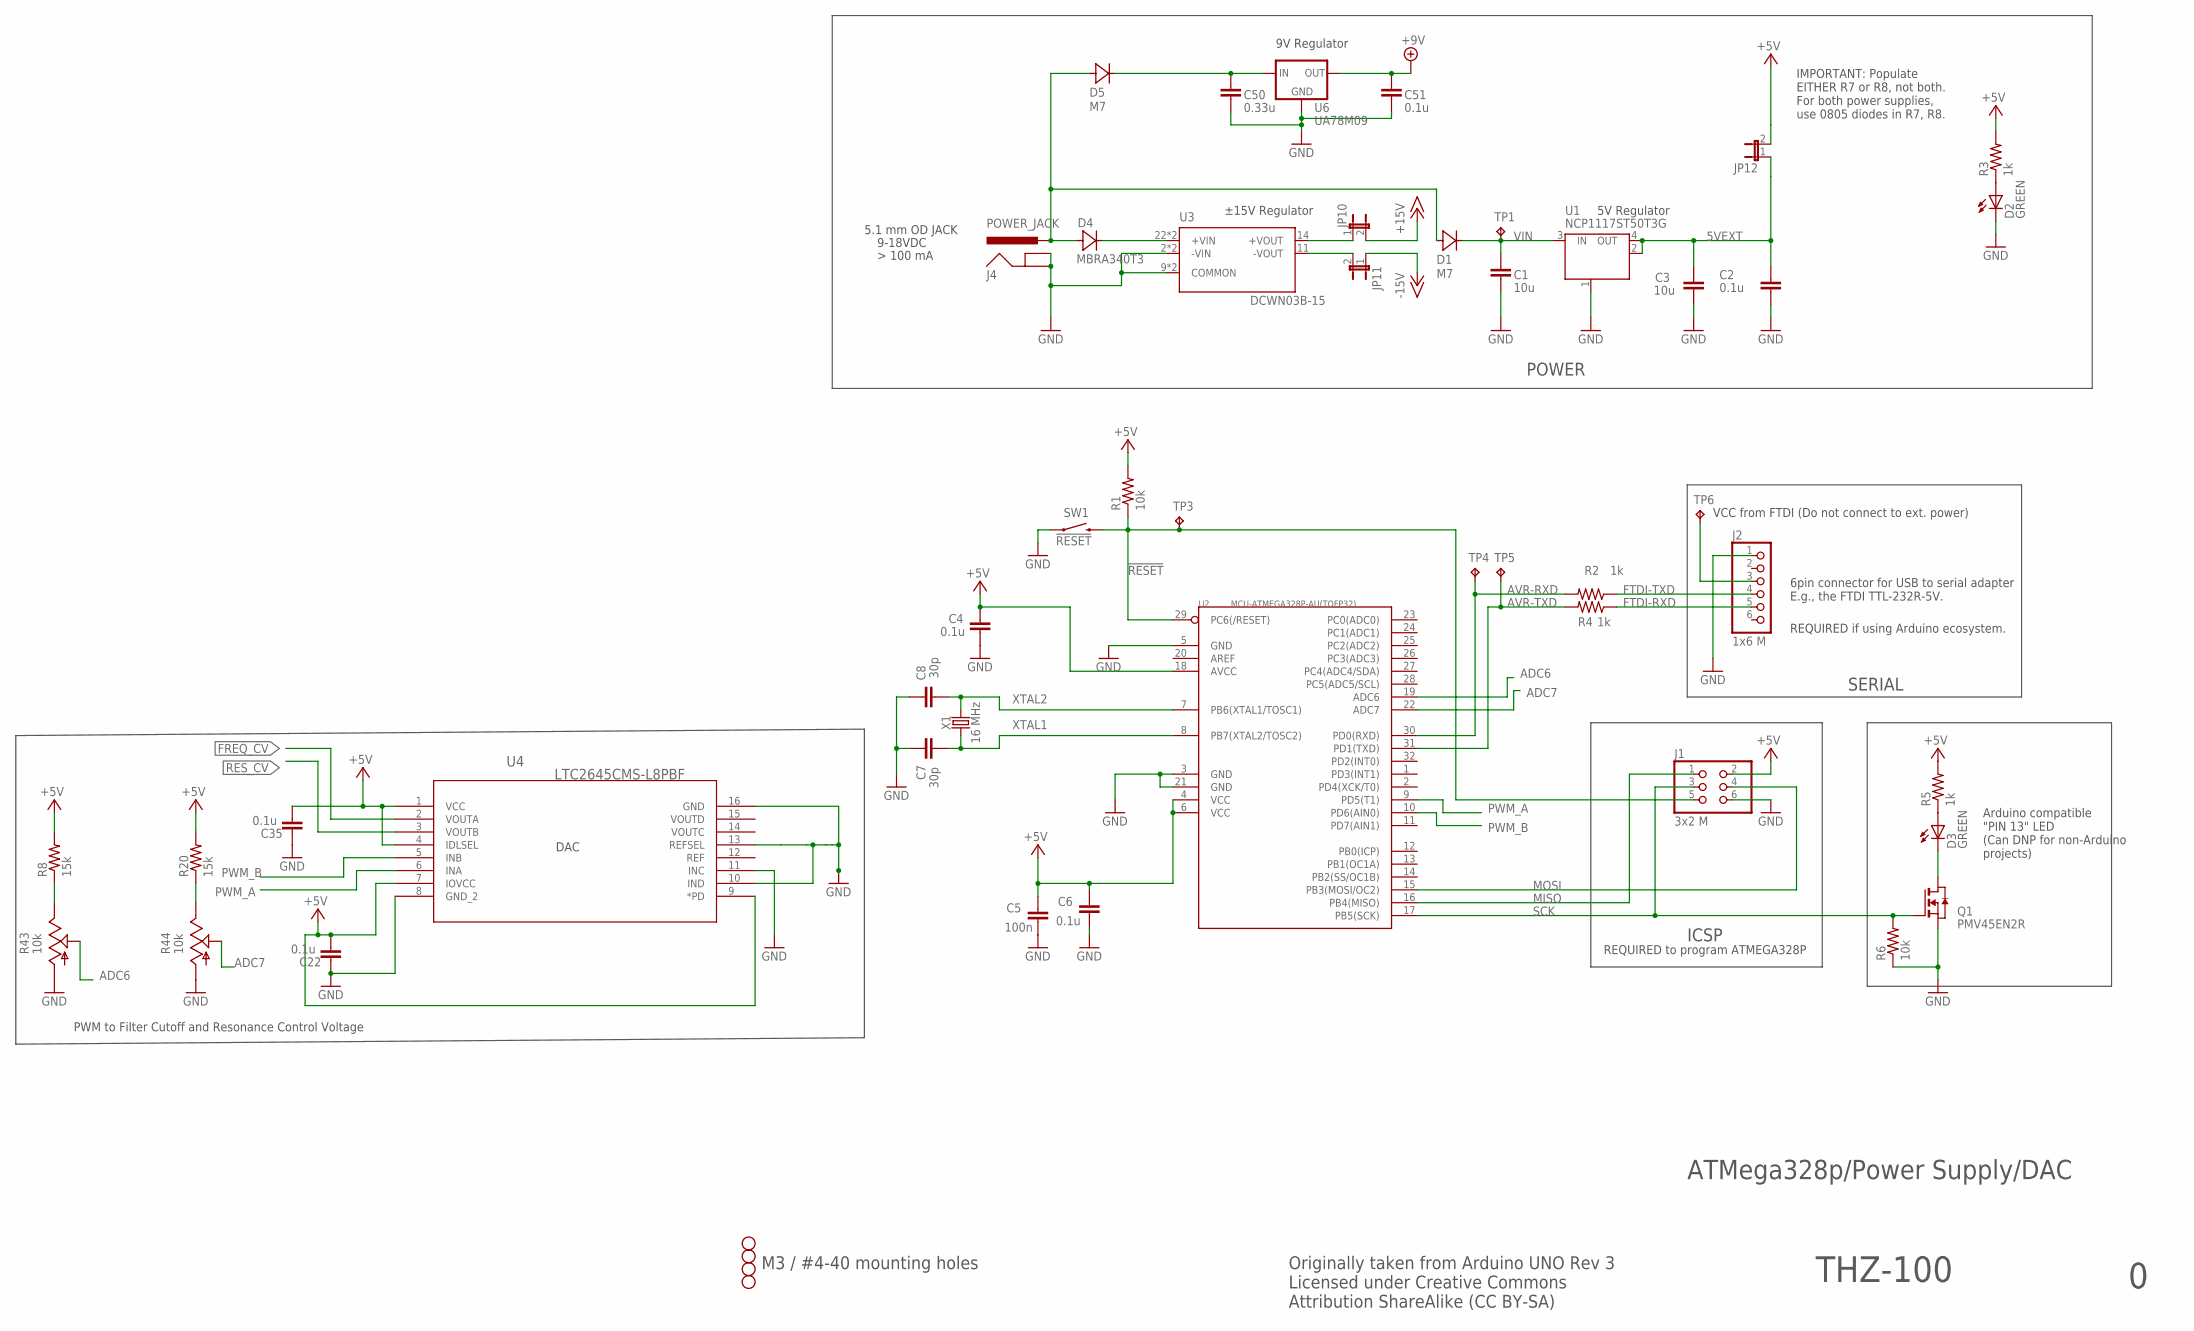
[picture p29: schematic Theremizer.sch, sheet 1]

Parts:
C1, C3: 10u; C0805; MPN CL21A106KOQNNNG
C2, C4, C6: 0.1u; C0805; MPN CL21B104KBCNNNC
C5: 100n; C0805; MPN CL21B104KBCNNNC
C7: 30p; C0805; MPN CL21C180JBANNNC
C8: 30p; C0805; MPN CL21C300JBANNNC
C22: 0.1u; C0805K; MPN CL21C300JBANNNC
C35: 0.1u; C0805; MPN CL21C300JBANNNC
C50: 0.33u; C0805; MPN CL21A106KOQNNNG
C51: 0.1u; C0805; MPN CL21A106KOQNNNG
D1, D5: M7; SMA; MPN 10BQ030TR
D2, D3: GREEN; CHIP-LED0805; MPN 150080GS75000
D4: MBRA340T3; SMA
H1, H2, H3, H4: STAND-OFF
J1: 3x2 M; 2X03; MPN M20-9980345
J2: 1x6 M; 1X06; MPN PRPC006SAAN-RC
J4: POWER_JACK; POWER_JACK_PTH; MPN PJ-202A
JP10, JP11, JP12: JP1E; JP1
Q1: PMV45EN2R; SOT-23; MPN PMV45EN2R
R1, R6: 10k; R0805; MPN RC0805FR-0710KL
R2, R3, R4, R5: 1k; R0805; MPN RC0805FR-071KL
R8, R20: 15k; R0805; MPN RC0805FR-0710KL
R43, R44: 10k; B64Y
SW1: !RESET; TACTILE_SWITCH_SMD; MPN RS-187R05A2-DS MT RT
TP1, TP3, TP4, TP5, TP6: TPPAD1-13; P1-13
U1: NCP1117ST50T3G; SOT223; MPN NCP1117ST50T3G
U2: MCU-ATMEGA328P-AU(TQFP32); TQFP32-0.8-7X7MM
U3: DCWN03B-15; DIP1549W45P254L3404H940Q24
U4: LTC2645CMS-L8PBF; MSOP-16_MS
U6: UA78M09; DPACK
X1: 16 MHz; HC49UP; MPN ECS-160-18-5PX-TR

Connections:
5VEXT: C2.2, C3.1, JP12.1, U1.2 (OUT), U1.4 (OUT)
!RESET: J1.5, R1.1, SW1.3 (2), TP3.TP, U2.29 (PC6(/RESET))
+5V: C4.2, C5.2, C6.2, C22.1, C35.1, J1.2, JP12.2, R1.2, R3.2, R5.2, R8.2, R20.2, U2.4 (VCC), U2.6 (VCC), U2.18 (AVCC), U4.1 (VCC), U4.4 (IDLSEL), U4.7 (IOVCC), U4.9 (*PD); also elsewhere on the board
+9V: C51.1, U6.3 (OUT); also elsewhere on the board
+15V: JP10.2; also elsewhere on the board
-15V: JP11.1; also elsewhere on the board
ADC6: R43.S, U2.19 (ADC6)
ADC7: R44.S, U2.22 (ADC7)
AVR-RXD: R2.2, TP4.TP, U2.30 (PD0(RXD))
AVR-TXD: R4.2, TP5.TP, U2.31 (PD1(TXD))
FREQ_CV: U4.2 (VOUTA); also elsewhere on the board
FTDI-RXD: J2.5, R4.1
FTDI-TXD: J2.4, R2.1
GND: C1.2, C2.1, C3.2, C4.1, C5.1, C6.1, C7.2, C8.2, C22.2, C35.2, C50.2, C51.2, D2.C, J1.6, J2.1, J4.GND, J4.GNDBREAK, Q1.2 (S), R6.1, R43.A, R44.A, SW1.1, U1.1 (GND/ADJ), U2.3 (GND), U2.5 (GND), U2.21 (GND), U3.2 (-VIN), U3.3 (-VIN), U3.9 (COMMON), U3.16 (COMMON), U4.8 (GND_2), U4.10 (IND), U4.11 (INC), U4.13 (REFSEL), U4.16 (GND), U6.4 (GND); also elsewhere on the board
MISO: J1.1, U2.16 (PB4(MISO))
MOSI: J1.4, U2.15 (PB3(MOSI/OC2))
unnamed: D3.A, R5.1
unnamed: D2.A, R3.1
unnamed: D3.C, Q1.1 (D)
unnamed: J2.3, TP6.TP
unnamed: C50.1, D5.C, U6.1 (IN)
unnamed: D1.A, D4.A, D5.A, J4.PWR
unnamed: D4.C, U3.22 (+VIN), U3.23 (+VIN)
unnamed: JP10.1, U3.14 (+VOUT)
unnamed: JP11.2, U3.11 (-VOUT)
unnamed: R8.1, R43.E
unnamed: R20.1, R44.E
PWM_A: U2.9 (PD5(T1)), U4.6 (INA)
PWM_B: U2.10 (PD6(AIN0)), U4.5 (INB)
RES_CV: U4.3 (VOUTB); also elsewhere on the board
SCK: J1.3, Q1.3 (G), R6.2, U2.17 (PB5(SCK))
VIN: C1.1, D1.C, TP1.TP, U1.3 (IN)
XTAL1: C7.1, U2.8 (PB7(XTAL2/TOSC2)), X1.1
XTAL2: C8.1, U2.7 (PB6(XTAL1/TOSC1)), X1.2

Notes on the sheet:
9-18VDC
POWER
ICSP
5.1 mm OD JACK
6pin connector for USB to serial adapter E.g., the FTDI TTL-232R-5V.
REQUIRED if using Arduino ecosystem.
M3 / #4-40 mounting holes
SERIAL
REQUIRED to program ATMEGA328P
Arduino compatible "PIN 13" LED (Can DNP for non-Arduino projects)
VCC from FTDI (Do not connect to ext. power)
IMPORTANT: Populate EITHER R7 or R8, not both. For both power supplies, use 0805 diodes in R7, R8.
Originally taken from Arduino UNO Rev 3 Licensed under Creative Commons Attribution ShareAlike (CC BY-SA)
PWM to Filter Cutoff and Resonance Control Voltage
DAC
ATMega328p/Power Supply/DAC
9V Regulator
±15V Regulator
5V Regulator
THZ-100

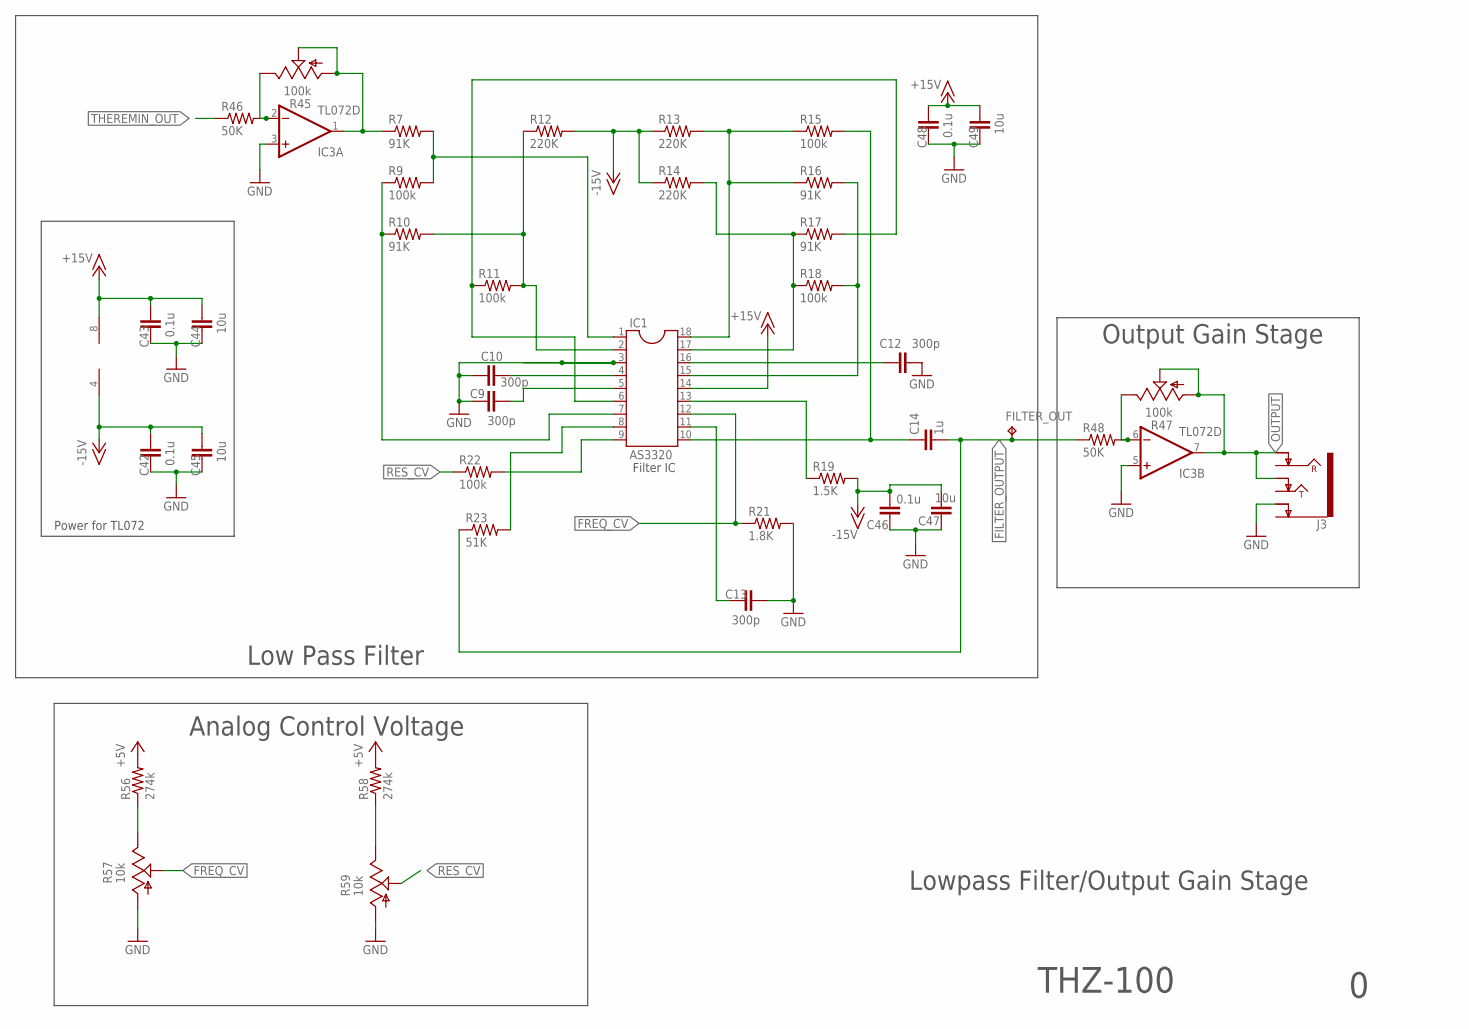
[picture p30: schematic Theremizer.sch, sheet 2]

Parts:
C9, C10, C12, C13: 300p; C0805
C14: 1u; C0805
C42, C43, C46, C48: 0.1u; C0805
C44, C45, C47, C49: 10u; C0805
FILTER_OUT: TPB2,54; B2,54
IC1: AS3320; SOCKET-18
IC3: TL072D; SO08
J3: AUDIO_JACK_TRS_0.25"_PTH_RA; AUDIO_JACK_0.25"_TRS_PTH_RA
R7, R10, R16, R17: 91K; R0805
R9, R11, R15, R18, R22: 100k; R0805
R12, R13, R14: 220K; R0805
R19: 1.5K; R0805
R21: 1.8K; R0805
R23: 51K; R0805
R45, R47: 100k; B64Y
R46, R48: 50K; R0805
R56, R58: 274k; R0805
R57, R59: 10k; B64Y

Connections:
+5V: R56.2, R58.2; also elsewhere on the board
+15V: C43.2, C44.2, C48.2, C49.2, IC1.14, IC3.8 (V+); also elsewhere on the board
-15V: C42.2, C45.2, C46.2, C47.2, IC3.4 (V-), R12.2, R13.1, R14.1, R19.2; also elsewhere on the board
FILTER_OUTPUT: C14.2, FILTER_OUT.TP, R23.1, R48.1; also elsewhere on the board
FREQ_CV: IC1.12, R21.1, R57.S; also elsewhere on the board
GND: C9.1, C10.1, C12.2, C13.2, C42.1, C43.1, C44.1, C45.1, C46.1, C47.1, C48.1, C49.1, IC1.3, IC3.3 (+IN), IC3.5 (+IN), J3.SLEEVE-NORM (EARTH-NORM), R21.2, R57.A, R59.A; also elsewhere on the board
unnamed: IC1.1, R7.2, R9.2
unnamed: IC1.7, R9.1, R10.1
unnamed: C9.2, IC1.5
unnamed: C10.2, IC1.4
unnamed: IC1.2, R10.2, R11.2, R12.1
unnamed: IC1.6, R11.1, R17.2
unnamed: C14.1, IC1.10, R15.2
unnamed: IC1.18, R13.2, R15.1, R16.1
unnamed: IC1.17, R14.2, R17.1, R18.1
unnamed: IC1.15, R16.2, R18.2
unnamed: C12.1, IC1.16
unnamed: IC1.13, R19.1
unnamed: C13.1, IC1.11
unnamed: IC3.2 (-IN), R45.E, R46.2
unnamed: IC1.8, R23.2
unnamed: IC1.9, R22.2
unnamed: R56.1, R57.E
unnamed: IC3.1 (OUT), R7.1, R45.A, R45.S
unnamed: IC3.6 (-IN), R47.E, R48.2
unnamed: R58.1, R59.E
OUTPUT: IC3.7 (OUT), J3.RING-NORM, J3.TIP-NORM, R47.A, R47.S; also elsewhere on the board
RES_CV: R22.1, R59.S; also elsewhere on the board
THEREMIN_OUT: R46.1; also elsewhere on the board

Notes on the sheet:
Low Pass Filter
Power for TL072
Output Gain Stage
Filter IC
Analog Control Voltage
Lowpass Filter/Output Gain Stage
THZ-100

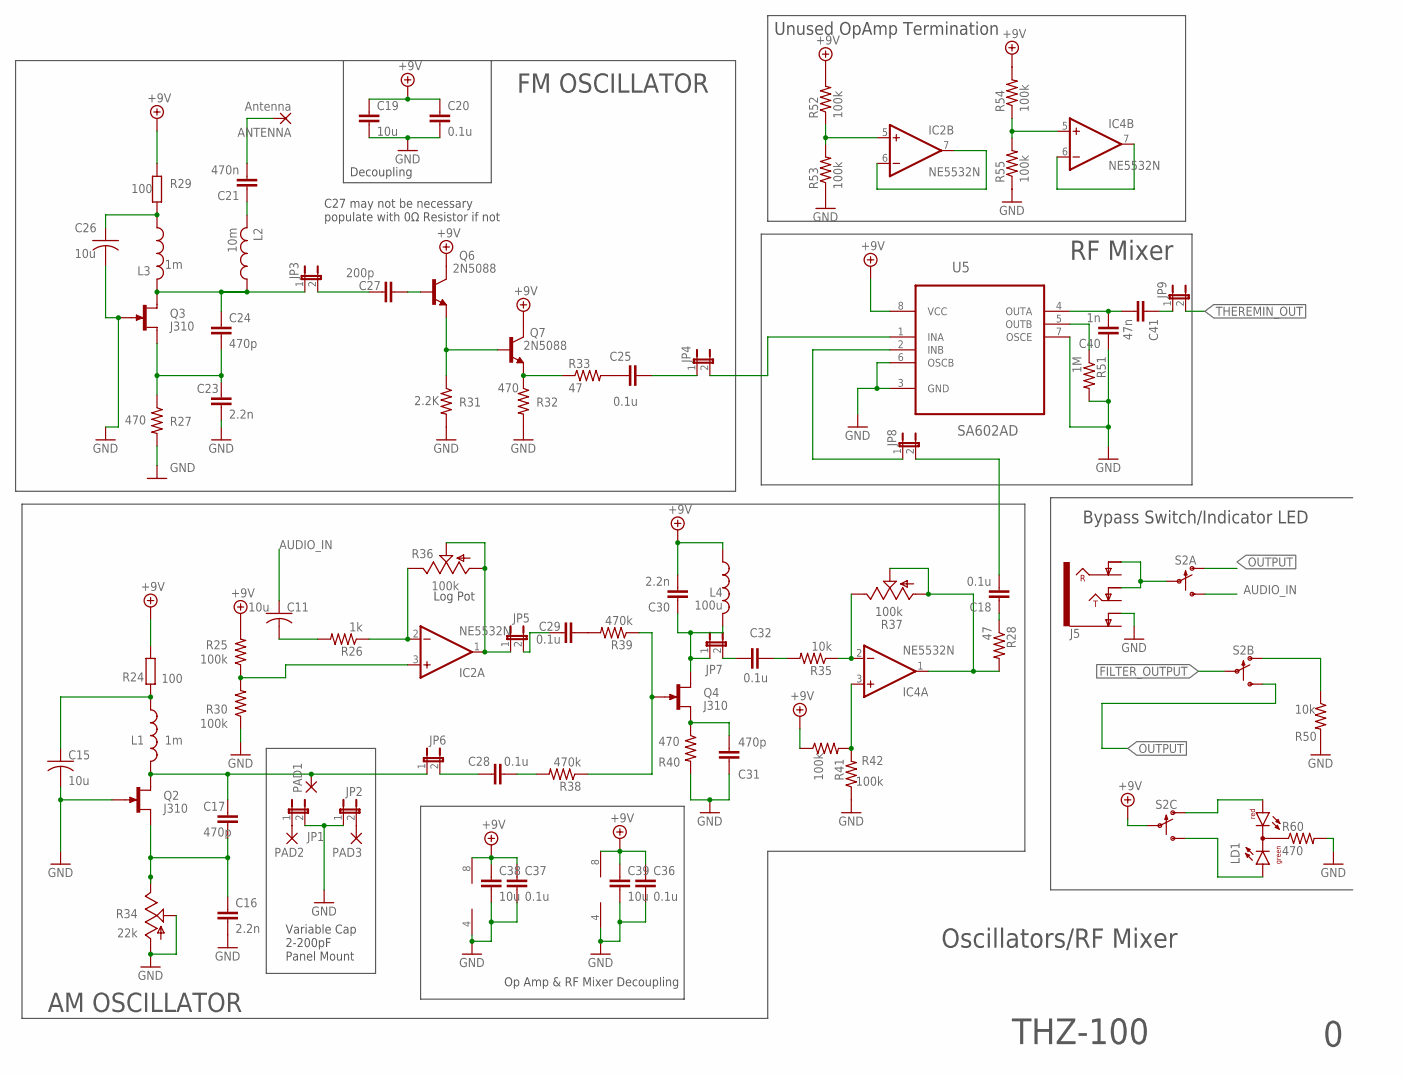
[picture p31: schematic Theremizer.sch, sheet 3]

Parts:
ANTENNA: Antenna; 2,54/1,1
C11, C15, C26: 10u; C050-025X075
C16, C23, C30: 2.2n; C0805
C17, C24, C31: 470p; C0805
C18, C20, C25, C28, C29, C32, C36, C37: 0.1u; C0805
C19, C38, C39: 10u; C0805
C21: 470n; C0805
C27: 200p; C0805
C40: 1n; C0805
C41: 47n; C0805
IC2, IC4: NE5532N; DIL08
J5: AUDIO_JACK_TRS_0.25"_PTH_RA; AUDIO_JACK_0.25"_TRS_PTH_RA
JP1, JP2, JP3, JP4, JP5, JP6, JP7, JP8, JP9: JP1E; JP1
L1, L3: 1m; 6000-XXXX-RC
L2: 10m; 6000-XXXX-RC
L4: 100u; 6000-XXXX-RC
LD1: DUOLED-RG-C; DUOLED-C-5MM
PAD1, PAD2, PAD3: 2,15/1,0
Q2, Q3, Q4: J310; TO92R
Q6, Q7: 2N5088; TO92
R24, R29: 100; PRL1632
R25, R30, R41, R42, R52, R53, R54, R55: 100k; R0805
R26: 1k; R0805
R27, R32, R40, R60: 470; R0805
R28, R33: 47; R0805
R31: 2.2K; R0805
R34: 22k; B64Y
R35, R50: 10k; R0805
R36, R37: 100k; B64Y
R38, R39: 470k; R0805
R51: 1M; R0805
S2: SWITCH-3PDT-PTH-STOMP; STOMP_SWITCH_3PDT
U5: SA602AD; SO8

Connections:
+9V: C19.1, C20.1, C30.2, C36.1, C37.1, C38.1, C39.1, IC2.8 (V+), IC4.8 (V+), L4.1, Q6.1 (C), Q7.1 (C), R24.2, R25.2, R29.1, R41.1, R52.2, R54.2, S2.P$8, U5.8 (VCC); also elsewhere on the board
ANTENNA: ANTENNA.1, C21.2
AUDIO_IN: C11.1, S2.P$3 (S)
FILTER_OUTPUT: S2.P$5; also elsewhere on the board
GND: C15.2, C16.2, C19.2, C20.2, C23.2, C26.2, C31.1, C36.2, C37.2, C38.2, C39.2, C40.1, IC2.4 (V-), IC4.4 (V-), J5.SLEEVE-NORM (EARTH-NORM), JP1.2, JP2.1, Q2.G, Q3.G, R27.2, R30.1, R31.2, R32.2, R34.A, R34.S, R40.2, R42.1, R50.2, R51.2, R53.1, R55.1, R60.2, U5.3 (GND), U5.6 (OSCB), U5.7 (OSCE); also elsewhere on the board
unnamed: C21.1, L2.2
unnamed: C15.1, L1.1, R24.1
unnamed: C18.1, R28.1
unnamed: JP4.2, U5.1 (INA)
unnamed: C25.1, R33.2
unnamed: C24.1, JP3.1, L2.1, L3.2, Q3.D
unnamed: C27.2, Q6.2 (B)
unnamed: IC2.3 (+IN), R25.1, R30.2
unnamed: IC4.3 (+IN), R41.2, R42.2
unnamed: Q6.3 (E), Q7.2 (B), R31.1
unnamed: Q7.3 (E), R32.1, R33.1
unnamed: C32.1, R35.2
unnamed: C16.1, C17.2, Q2.S, R34.E
unnamed: C17.1, JP6.1, L1.2, PAD1.1, Q2.D
unnamed: JP8.1, U5.2 (INB)
unnamed: J5.RING-NORM, J5.TIP-NORM, S2.P$2
unnamed: R50.1, S2.P$4 (O)
unnamed: C11.2, R26.2
unnamed: IC2.2 (-IN), R26.1, R36.E
unnamed: IC2.1 (OUT), JP5.1, R36.A, R36.S
unnamed: C29.2, R39.2
unnamed: C28.2, R38.2
unnamed: Q4.G, R38.1, R39.1
unnamed: C30.1, JP7.1, L4.2, Q4.D
unnamed: C31.2, Q4.S, R40.1
unnamed: IC4.2 (-IN), R35.1, R37.E
unnamed: IC4.1 (OUT), R28.2, R37.A, R37.S
unnamed: LD1.AR, S2.P$7 (O)
unnamed: C26.1, L3.1, R29.2
unnamed: LD1.AX (AG), S2.P$9 (S)
unnamed: R51.1, U5.5 (OUTB)
unnamed: IC2.6 (-IN), IC2.7 (OUT)
unnamed: IC2.5 (+IN), R52.1, R53.2
unnamed: IC4.5 (+IN), R54.1, R55.2
unnamed: IC4.6 (-IN), IC4.7 (OUT)
unnamed: C23.1, C24.2, Q3.S, R27.1
unnamed: JP1.1, PAD2.1
unnamed: JP2.2, PAD3.1
unnamed: C27.1, JP3.2
unnamed: C25.2, JP4.1
unnamed: C29.1, JP5.2
unnamed: C28.1, JP6.2
unnamed: C32.2, JP7.2
unnamed: C18.2, JP8.2
unnamed: C40.2, C41.2, U5.4 (OUTA)
unnamed: LD1.C, R60.1
unnamed: C41.1, JP9.1
OUTPUT: S2.P$1 (O), S2.P$6 (S); also elsewhere on the board
THEREMIN_OUT: JP9.2; also elsewhere on the board

Notes on the sheet:
AM OSCILLATOR
FM OSCILLATOR
C27 may not be necessary populate with 0Ω Resistor if not
Decoupling
Op Amp & RF Mixer Decoupling
RF Mixer
Bypass Switch/Indicator LED
Log Pot
Unused OpAmp Termination
Variable Cap 2-200pF Panel Mount
Oscillators/RF Mixer
THZ-100

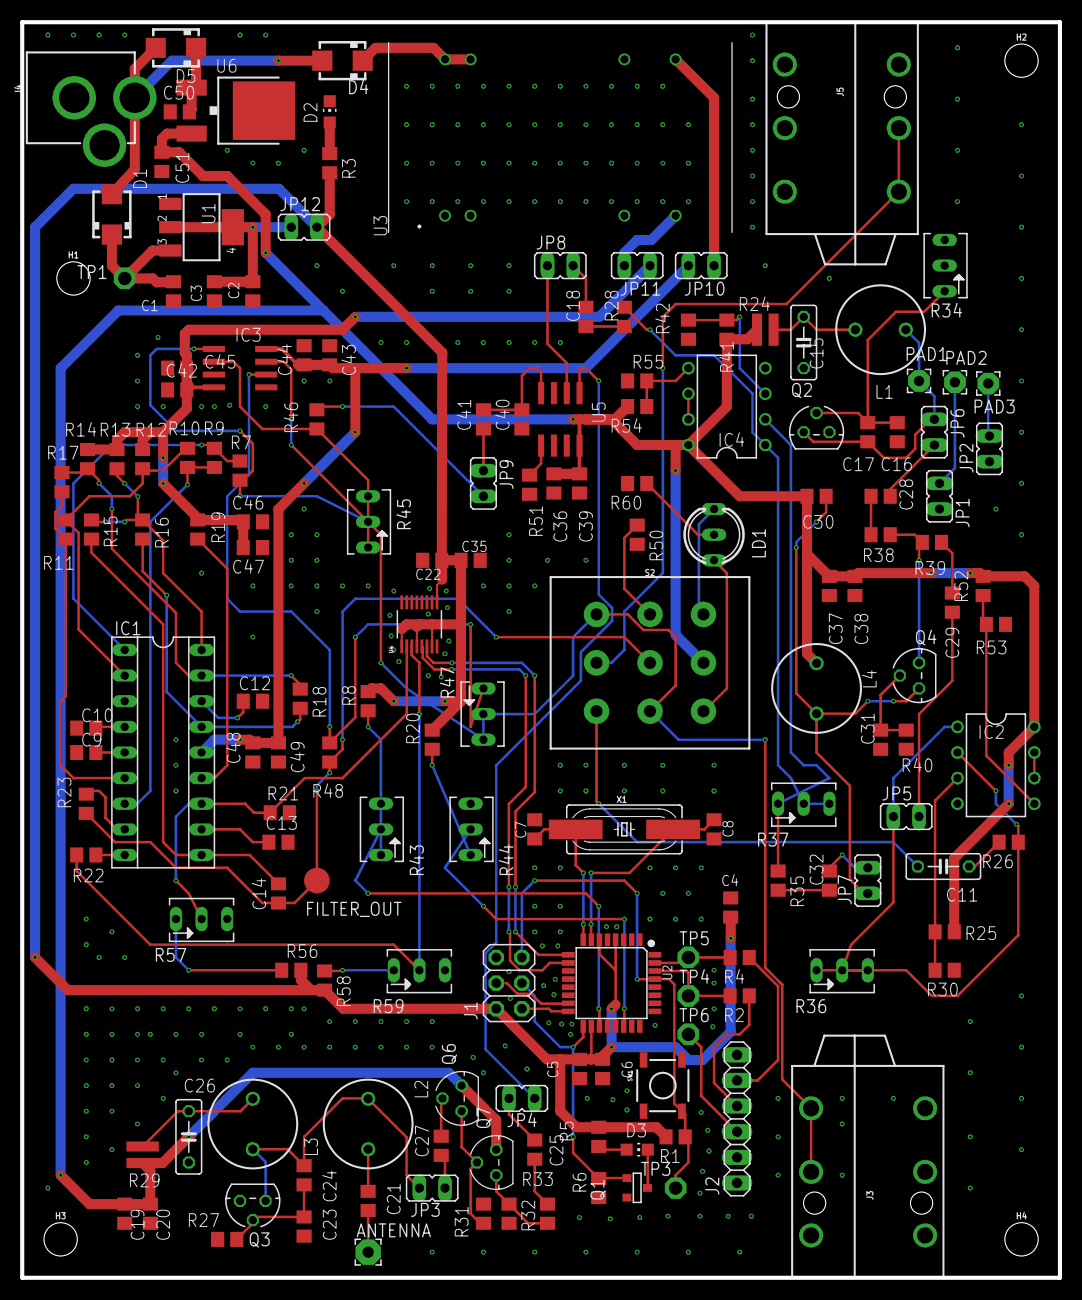
[picture p32: board Theremizer.brd from above]

Board: 2 copper layers, 102.9 x 124.5 mm, 168 parts (0 on the bottom side), 106 nets.
