kaibrooks/synthy/(commit log)

2019-10-14 Basic Oscillator Schematics with Antenna Loading Coil and tuning circuit
2019-10-15 Added AM modulator circuit, good antenna coil, 50ohm buffers to both oscillators.
2019-10-16 Didn't have word wrap on 😑
2019-10-16 My idea plus adds to schematic
2019-10-16 HW2 Final
    haha, this one is final haha haha 😅
2019-10-17 BOM Initial
    I will add more to this as the schematic is populated
    [BOM.xlsx]
2019-10-17 More components
    [BOM.xlsx]
2019-10-21 BOM Update
    [BOM.xlsx]
2019-10-23 Added Optional Audio In to BD
    Also, added original schematic file for further edits if needed.
2019-10-24 Cut it down to 3 pages because I can't read requirements
2019-10-29 Changed oscillators to common base JFET, set up 50ohm output buffers.
2019-10-30 Schematic, probably 40% Done
    [Theremizer.brd, Theremizer.sch]
2019-10-30 Added filter and theremin/freq mixer to circuit
2019-11-04 Finished front end, oscillators and input circuit through to mixer. 100mV-1V inputs.
2019-11-06 Initial Board
    [Theremizer.brd]
2019-11-07 caught a schematic error in the tuning nodes on the oscillators
2019-11-07 Inital board & bunch of schematic changes
    [BOM.xlsx, Theremizer.brd, Theremizer.sch]
2019-11-07 Initial BOM commit
    [Theremizer_BOM.csv]
2019-11-07 Package size change
    [Theremizer.brd, Theremizer.sch]
2019-11-14 BOM Update, more to come before 10AM
    [Theremizer_BOM.csv]
2019-11-14 Almost complete BOM
    [Theremizer.brd, Theremizer.sch, Theremizer_BOM.csv]
2019-11-14 Test point for filter out
    [Theremizer.brd, Theremizer.sch]
2019-11-15 Added bypass, new mixer
    [Theremizer.brd, Theremizer.sch]
2019-11-15 Added stuff
    [Theremizer.brd, Theremizer.sch]
2019-11-16 Changed cap values for mixer output, added decoupling caps, 9V regulator
    [Theremizer.brd, Theremizer.sch]
2019-11-18 most of BOM stuff
    [Total Used Materials.xlsx]
2019-11-18 finalized spice scheme, digikey bom, total bom
    [Digikey Theremizer BOM.csv, Total Used Materials.xlsx]
2019-11-19 Added decoupling caps and analog CV
    [Theremizer.brd, Theremizer.sch]
2019-11-19 updated to reflect currently purchased items
    [Total Used Materials.xlsx]
2019-11-20 Last BOM
    [Theremizer.brd, Theremizer.sch, TheremizerBOM_11192019.csv]
2019-11-20 Redid layout, hopefully better
    [Theremizer.brd, Theremizer.sch]
2019-11-20 Board laid out by hand, still needs vias
    [Theremizer.brd, Theremizer.sch]
2019-11-20 Now with 1000000x more vias
    [Theremizer.brd]
2019-11-21 Auto stash before merge of "master" and "origin/master"
    Hopefully complete BOM and list of all used materials/sources
    [Digikey Theremizer BOM.csv, Total Used Materials.xlsx]
2019-11-21 Final Schematic/Board Layout
    [Theremizer.brd, Theremizer.sch, Theremizer_Logo.brd]
2019-11-22 Final Digikey BOM
    [Digikey Theremizer BOM.csv, Theremizer.brd]
2019-11-22 Final Digikey BOM/final Eagle BOM with values matching actual components
    [BOM.xlsx, Digikey Theremizer BOM.csv, Digikey_theremizer_BOM.csv, Theremizer_BOM.csv]
2019-11-28 Connected airwire from RES_CV nodes
    [Theremizer.brd]
2019-11-30 Two Use Cases for the Test Plan HW, both Excel Source and PDF
    [test cases.xlsx]
2019-12-04 Buncha random things, added .png of logo
    [Theremizer.brd]
2019-12-06 Code to have microcontroller function as a PWM
2019-12-10 Updated PWM code to generate correct duty cycles
    [PWM_code.ino]
2019-12-10 Board Things/Routing fixes
    [Theremizer.brd]
2019-12-11 Test Stuff and PCB layout
2019-12-11 Organized Repo
    [Digikey_theremizer_BOM.csv, Final_bom.xlsx, test cases.xlsx]
2019-12-11 Final Bom
    [Final_bom.xlsx]
